Intuiti0n/Projeto1-Smartband/reports/smartband_grupo3.pdf

# Projeto 1 – SmartBand

Micro e nanotecnologias

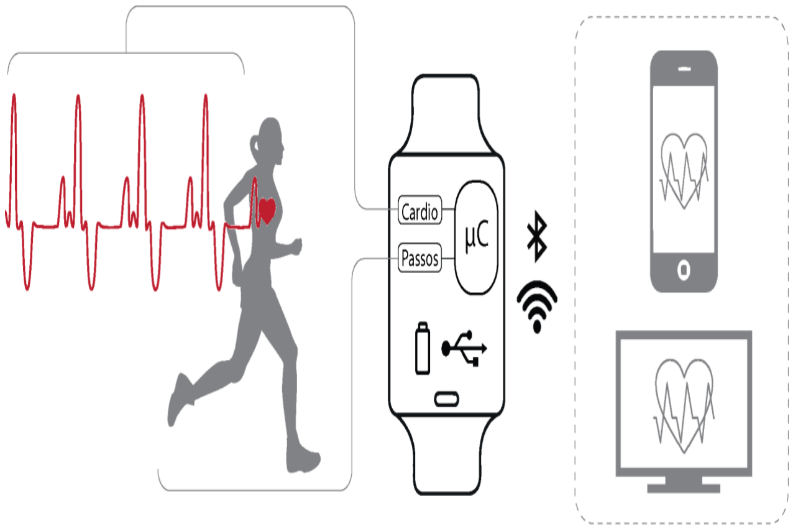
[picture p34: figure]

Trabalho realizado por:

Daniel Gomes A74729

Tiago Ferreira A71970

Pedro Vila-Chã A76468

Orientador do projeto:

Alexandre Silva

## Índice

Figura 6-dados da aceleração, vistos no dispositivo móvel. EIXO X, Y E Z correspondem,

Figura 18 fotopletismografia, esquema | Erro! Marcador não definido.
Figura 19 Diagrama de blocos do sensor de pulsação | Erro! Marcador não definido.
Figura 20-sinal amarelo: Saída do sensor, entrada do filtro. Sinal azul: sinal a saída do filtro
| Erro! Marcador não definido.
Figura 21 bloco amplificador | Erro! Marcador não definido.
Figura 22 imagem do sinal recolhido na porta serie do Arduino | Erro! Marcador não
definido.
Tabela 1-Preço dos vários componentes | Erro! Marcador não definido.

## Sumário

Neste projeto teve-se como principal objetivo a produção de uma

SmartBand que fosse competente a ponto de ser comparada com as já

existentes no mercado. Para que isso acontecesse, torna-se fundamental que

tanto o leitor de pulsos como o sensor de passos funcionem de forma o mais

preciso e fiável possível. Neste momento, finalizado o projeto, ficou

implementado o sensor de pulsação, o sensor de passos, sendo possível

observar os dados recolhidos por estes sensores num computador ou dispositivo

móvel (utilizando Bluetooth). A tentativa de implementação do projeto de uma

forma mais compacta, utilizando uma PCB, não resultou como esperado, sendo

detetados problemas na mesma durante os testes e portanto não foi possível

implementar o sistema desta forma.

A preocupação principal deste projeto foi uma aquisição limpa do sinal

que vinha do medidor de pulsos. Sendo esta a parte mais complicada, foi

necessário investir muito tempo e procurar diferentes métodos de tratamento dos

dados recolhidos. Era essencial que o sinal lido pelo hardware fosse o menos

distorcido possível de forma a facilitar o tratamento dessa mesma informação no

microcontrolador.

## Breves conclusões:

No geral, o projeto cumpriu os requisitos, sendo possível adquirir dados

dos vários sensores, visualiza-los num ecrã, por porta serie num computador ou

através de um dispositivo móvel utilizando Bluetooth.

## Introdução

Todos os elementos tiveram como primeira opção a escolha do projeto da

SmartBand, não só por estar incutido diretamente nas cadeiras que os alunos

estão a frequentar, mas também pela motivação que o projeto por si só oferecia,

sendo algo moderno e que cada vez mais ganha destaque no mercado dos

wearables, tornando o projeto mais aliciante.

O primeiro objetivo deste projeto era o de desenvolver um sensor de

pulsação, capaz de detetar os batimentos cardíacos de forma a calcular os

batimentos por minuto do utilizador da smartband. Para que tal fosse possível,

obrigou a que fosse realizado um estudo para determinar de que forma seria

mais fácil de detetar os batimentos, com que sensores e entre que valores varia

a frequência cardíaca dos humanos, de forma a desenvolver o circuito do sensor,

implementar o sensor numa bracelete e calcular os batimentos utilizando um

microcontrolador.

O segundo objetivo deste projeto centrou-se no desenvolvimento de um

sistema de aquisição de passos da marcha, o que levou a procura de informação

sobre qual sensor deveria ser utilizado, que algoritmo utilizar para contar os

passos efetuados pelo utilizador, como evitar que fosse detetado um passo

quando a pessoa efetua gestos estando parada, etc.

O terceiro objetivo consistia na visualização dos dados recolhidos pelos

sensores em tempo real num computador e também o seu envio por meio sem

fios para um terminal móvel, de forma a que fosse possível analisar a informação

que estava a chegar em qualquer momento. No caso do terminal móvel foi

desenvolvida uma aplicação, referida posteriormente neste relatório, que permite

visualizar os dados de forma mais intuitiva e simples.

O quarto objetivo resume-se a adicionar funções adicionais aquelas

especificadas no início deste projeto, neste caso consiste na visualização dos

dados num ecrã oled de 0,91 polegadas, sendo, portanto, possível observar os

dados dos sensores de três formas distintas.

## Estado da arte:

Seria impossível contornar o facto de o nosso projeto ser parecido com a

smartband mais utilizada do mercado “Xiaomi MiBand” de maneira que tentamos

sempre encontrar soluções baseando-nos em protocolos já existentes,

implementados e funcionais em dispositivos do mesmo tipo.

A principal fonte de informação foi pesquisada e encontrada em páginas

web, sendo a internet o meio que contém mais informação disponível ao alcance

de um “click”. No entanto, muitas vezes tivemos de aprofundar a pesquisa devido

à quantidade de informação disponível, que por vezes não tinha a maior

fidelidade.

Aproximando-se a reta final para entrega do projeto, era incontornável o

facto da implementação em pcb ter sido um fracasso, porém todos os

componentes conseguiam trabalhar em simultâneo e até houve opção de

adicionar um pequeno LCD que fornecia informação sobre o modo em que

estava (modo “0” -leitor de frequência cardíaca, modo”1” -contador de passos).

Outra funcionalidade que o MPU-6050 contém é a leitura da temperatura

ambiente, que foi devidamente testada e implementada com sucesso, porém não

chegou a avançar para o protótipo final.

Em suma, todos os componentes foram estudados previamente e

tentámos implementar cada um da maneira que achámos mais plausível e que

poderia trazer mais vantagens ao nosso projeto como produto.

Divisão do relatório:

Este relatório encontra-se dividido em 3 partes principais: fundamentos

teóricos, onde se descrevem os estudos realizados para os sensores de

pulsação e o de passos; trabalho realizado onde se descreve as dificuldades

encontradas, métodos utilizados e escolha de certos componentes; resultados

onde se indicam os resultados obtidos dos testes, ilustrados com imagens.

## Fundamentos teóricos:

Foto pletismografia (pulsação)

Uma das partes mais importantes deste projeto consiste na

implementação de um sistema de leitura de batimentos cardíacos, que fosse

robusto e o mais fiável possível. Para tal foi necessário realizar uma pesquiza

mais aprofundada sobre o tema em questão visto nenhum dos elementos do

grupo ter uma noção profunda sobre o assunto, sendo consultados vários

websites de fontes fidedignas sobre leitores de batimentos cardíacos, sendo que

foi descoberta a partida que os batimentos de uma pessoa se encontram

normalmente entre os 50 e os 240 por minuto, sendo 50 o valor de repouso e

240 um valor de grande esforço físico. De antemão já era conhecido o sistema

que iriamos utilizar, este fornecido pelo docente Prof. Alexandre Silva que

consistia | num | led | que | emitia | luz | verde | intensa | e | um | LDR

(Light Dependent Resistor) que seria o elemento que deteta as variações de

luminosidade.

Dado estes componentes, foi necessário elaborar um sistema que

conseguisse detetar a pulsação, (sensor do batimento cardíaco) baseando-se no

princípio da foto pletismografia. Este princípio consiste na medição da mudança

de volume de sangue através de qualquer órgão, que provoca do mesmo modo

uma variação na intensidade luminosa da região vascularizada. Neste caso,

como o que interessava era a medição da frequência da pulsação cardíaca, o

tempo entre pulsos é fundamental e deve ser detetado de forma precisa para

garantir um bom cálculo dos batimentos por minuto.

O fluxo de volume sanguíneo é dado pela taxa de pulsos cardíacos e,

como a luz é absorvida pelo sangue, os pulsos de sinal são equivalentes aos

pulsos de batimento cardíaco.

Aprofundando a pesquisa, foram encontrados dois tipos de foto pletismografia:

- Transmissão: A luz emitida a partir do dispositivo emissor de luz é

transmitida através de qualquer região vascular do corpo como o lóbulo

da orelha e recebida pelo detetor.

- Reflexão: A luz emitida pelo dispositivo emissor de luz é refletida pelas

regiões.

Acelerómetros para os passos:

Para contar os passos, foi necessário investigar sobre diferentes formas

de o fazer, sendo que o método adotado foi o de identificar um padrão de marcha

utilizando os eixos do acelerómetro. Era necessário entender de que forma os

valores obtidos pelo sensor eram importantes na contagem dos passos, se

apenas era dada importância a um dos eixos do acelerómetro, a dois dos eixos

ou a combinação dos três (calculando o vetor de aceleração total).

## Trabalho realizado:

Para o sensor de pulsação:

Para ser possível analisar a pulsação foi necessário criar um circuito que

fizesse com que os leds emitissem luz e no meio dos leds colocar o LDR

(elemento sensor), colocar estes elementos em contacto com o pulso e

consoante o fluxo sanguíneo (quanto maior o fluxo mais seria a luz absorvida,

ou seja, menos luz emitida para o LDR) receberíamos um valor de tensão que

variaria conforme o fluxo.

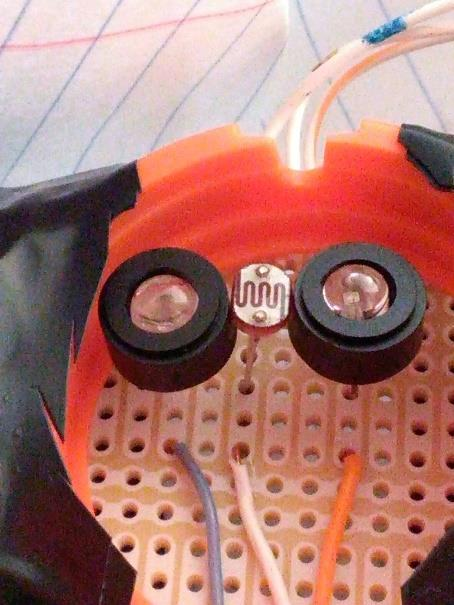
[picture p35: figure]

Figura 2-LDR e LEDs

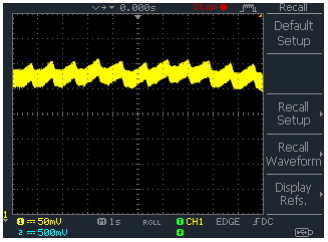
[picture p36: figure]

A variação da tensão à saída do LDR é inversamente proporcional ao fluxo

de sangue, caso o fluxo de sangue seja maior, maior será a absorção da luz,

logo menor será a luz refletida que o LDR captará de modo que terá menor valor

de tensão. Por outro lado, caso o fluxo seja menor, menor será a absorção de

luz, sendo maior a luz refletida para o LDR o que fará com que haja maior tensão

à sua saída. Este sinal é, na verdade, um sinal que varia de acordo com os

batimentos cardíacos, portanto a componente principal que era necessário isolar

era a do batimento. De forma a filtrar o ruído existente nesse sinal, foi necessário

implementar um filtro passivo passa banda, sendo que os limites para as

frequências foram determinados através do estudo prévio do sinal cardíaco.

Como os batimentos variam entre os 50 e os 240, isso corresponde a uma banda

de frequências que se encontra entre os 0,83Hz e os 4Hz. Portanto foi

Figura 1-Sinal á saída implementado um filtro passa banda de 0,5Hz a 10Hz de forma a atenuar apenas

as frequências que não se encontrassem na gama do sinal cardíaco.

Em termos de circuito isto correspondeu a implementar um filtro passivo

(utilizando apenas resistências e condensadores) cujos valores de frequência de

corte são os seguintes:

FC =

1
2 ∗ π ∗ R ∗ C

FC1 =

1
2 ∗ π ∗ 470k ∗ 680n = 0,50 Hz

FC2 =

1
2 ∗ π ∗ 160k ∗ 100n = 9,95 Hz

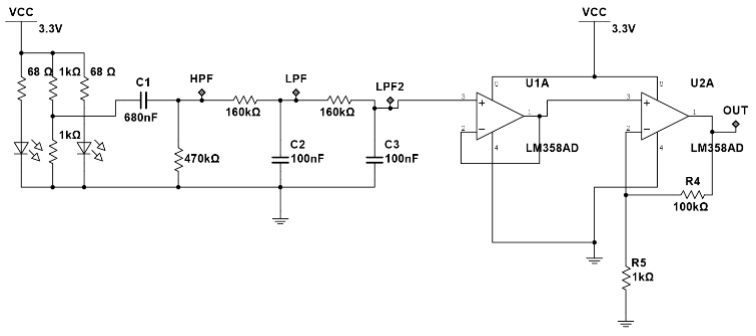
[picture p37: figure]

Foram utilizados 2 filtros passa baixo seguidos de forma a atenuar sinais

de alta frequência que estavam a perturbar a aquisição do sinal cardíaco, quando

se iniciaram os testes ao primeiro filtro implementado.

Figura 3-Circuito completo

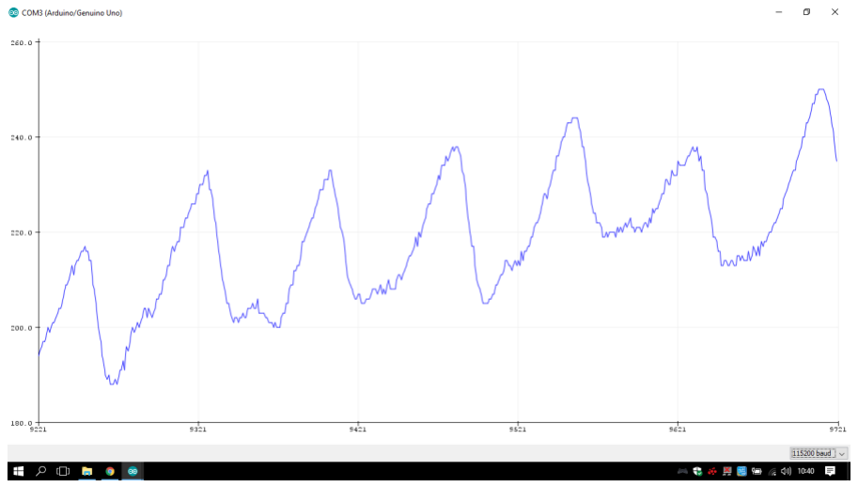
[picture p38: figure]

Dado que o sinal que estava a ser adquirido pelo microcontrolador possuía

uma componente DC que dificultava a tarefa da contagem dos batimentos,

recorreu-se a um filtro digital, de forma a normalizar o sinal e centrar em torno

de uma referência (valor 0).


Figura 5-Sinal após implementação do filtro digital

Após a implementação deste circuito e do filtro digital e posteriores testes,

foi possível criar um algoritmo de contagem dos batimentos. Todos os algoritmos

definidos se basearam num principio: o sinal passava por zero a cada pulso.

Portanto, inicialmente foi criado um algoritmo que a cada vez que o valor do sinal

passava de negativo para positivo (transição positiva) contava uma pulsação. De

Figura 4-Sinal á saída da porta série no Arduino forma a estimar os batimentos por minuto, num período de 6 segundos eram

contados os batimentos que ocorreram e o seu valor era multiplicado por 10 de

forma a estimar o valor de BPM (batimentos por minuto).

Este algoritmo, embora muito simples de implementar, revelou-se muito

pouco preciso devido a apenas ter em conta o numero de batimento que ocorrem

naquele espaço de tempo e não o tempo que cada pulso demora.

Portanto, implementou-se um novo algoritmo, que consistia em anotar o

tempo que cada pulso, em 5 pulsos, realizar uma regra de três simples e estimar

o valor de BPM. Este algoritmo, embora melhor que o primeiro, revelou-se muito

sensível a falsas leituras ou erros na leitura. Portanto procedeu-se a elaboração

de um sistema mais robusto.

O algoritmo que se revelou o melhor de todos consiste na anotação de 5

tempos em que o sinal passa pela referencia, determinar o período de 4 pulsos,

dividir por 4 o valor obtido e calcular deste modo a frequência (frequência é o

inverso do período). Como se realiza a media dos pulsos, os erros na leitura do

sinal são desta forma atenuados e deste modo é obtido um cálculo mais

aproximado do valor real.

## Para o sensor de passos:

Inicialmente foi efetuada uma recolha de dados, colocando o modulo com

acelerómetro no pulso e analisando os dados a procura de um padrão. Foi

possível verificar que dada a posição do sensor no pulso, os eixos Y e Z de

aceleração era aqueles em que era mais facilmente percetível o padrão da

marcha [ver figura X], obtendo picos em ambos os eixos. Dado que por vezes

com o movimento natural dos braços do utilizador um desses eixos não dava um

pico acentuado, foi necessário combinar a informação dos sinais dos 2 eixos.

Primeiro foi adotada a estratégia de uma soma aritmética dos valores dos 2

eixos, sendo posteriormente decidido que uma multiplicação aritmética dos

valores a cada instante permitiria realçar o aumento dos valores quando a

pessoa efetua a passada. A partir desta operação, foi possível estabelecer um

algoritmo básico de deteção dos passos, sendo que este consiste na comparação com um valor base e sempre que os dados provenientes do sensor

ultrapassam este limiar, aumenta o numero de passos.

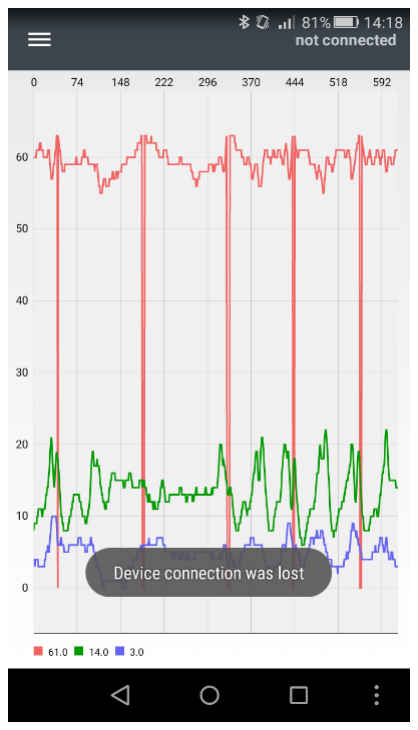
[picture p39: figure]

Figura 6-dados da aceleração, vistos no dispositivo móvel. EIXO X, Y E Z correspondem, respetivamente as cores vermelho, verde e azul

A aquisição de passos recorreu a utilização do sensor MPU-6050, que medirá a aceleração do braço.
Este sensor contém um acelerómetro e um
giroscópio num único chip. Tendo 16-bits para cada
canal de conversão ADC e o facto de captar os eixos X, Y, Z tornam este módulo ideal para a contagem dos passos. O sensor usa o protocolo I2C para realizar a comunicação com o Arduíno.
Uma das principais preocupações neste projeto
foi o baixo consumo de energia, pois este será
alimentado recorrendo a uma bateria, sendo este

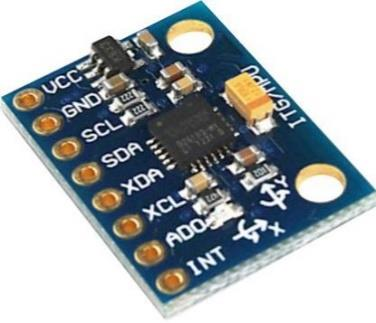
[picture p40: figure]

módulo uma boa escolha devido a possuir uma função de “sleep” não requer um alto consumo sendo esta uma das características que levou a que fosse escolhido.

Figura 7-MPU-6050

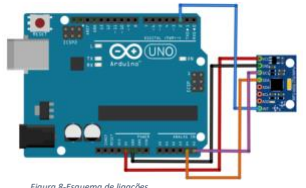
[picture p41: figure]

## Desenvolvimento de aplicação

Ao utilizar o módulo Bluetooth para a comunicação sem fios com o dispositivo Android pensou-se que seria melhor desenvolver uma aplicação, para tal recorreu-se ao “MIT app Inventor”, que é um ambiente de desenvolvimento de fácil compreensão, com exemplos que auxiliam a sua utilização. Dada a inexperiência dos membros do grupo a programar uma aplicação móvel, esta foi a opção mais sensata, pois este utiliza programação por blocos para executar os diversos comandos.

O objetivo da aplicação seria o de apresentar os gráficos dos três eixos que são enviados pelo acelerómetro, tendo também um pequeno botão para conectar ou desconectar. O layout da aplicação estará apresentado na figura seguinte assim como o diagrama de blocos utilizado.

Figura 8-Esquema de ligações

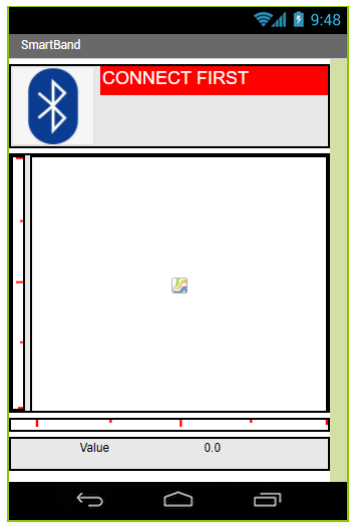
[picture p42: figure]

Figura 9-Layout da aplicação

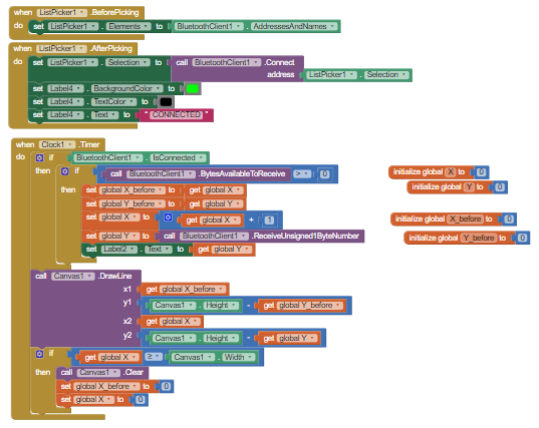
[picture p43: figure]

## Escolha do microcontrolador:

Dada a variedade de microcontroladores existentes no mercado, foi possível escolher um que se enquadrasse nas necessidades deste projeto de forma a ajudar no funcionamento de todo o sistema. Devido ao seu tamanho reduzido, foram considerados os seguintes microcontroladores: Arduino Nano, Arduino Pro Mini,

Adafruit Trinket.

Dados estes 3 dispositivos, foi selecionado o Arduino Pro Mini, devido a possuir um custo muito reduzido, tamanho bastante reduzido devido a não possuir uma ligação direta por usb e características internas (como por exemplo a alimentação de 3.3V, velocidade de 8MHz, bastantes pinos disponíveis caso existam funcionalidades extra a serem implementadas mais tarde) favoráveis em relação às outras opções.

Figura 10-Diagrama de blocos

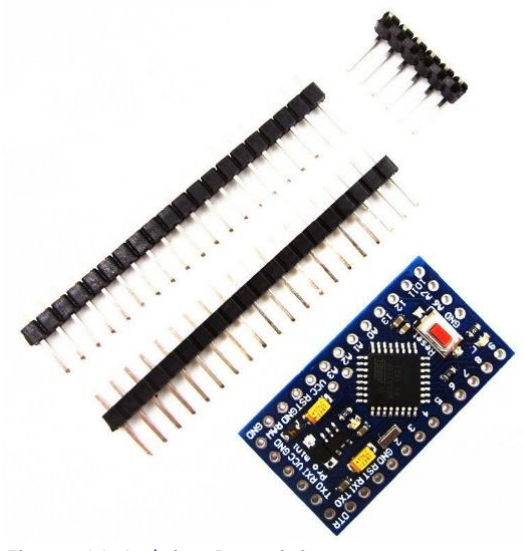
[picture p44: figure]

Figura 11-Arduino Pro mini

## Envio dos dados por Bluetooth:

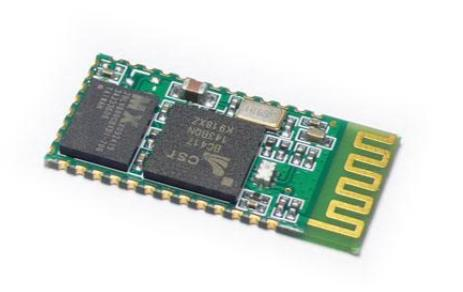
[picture p45: figure]

De forma a que fosse possível observar os dados obtidos pelos sensores num terminal móvel, foi necessário escolher um módulo Bluetooth, sendo que o escolhido foi o HC-05, devido ao seu preço, fácil programação e configuração e sendo este um módulo já utilizado por alguns membros do grupo antes deste projeto, foi a escolha mais fácil de implementar.

## Resultados obtidos:

Do sensor de pulsação:

Figura 12-módulo Bluetooth HC-05

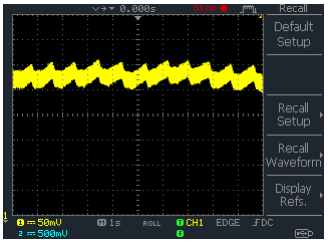
[picture p46: figure]

Figura 13-Sinal obtido do LDR

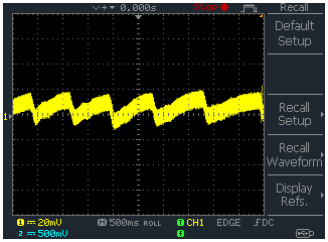
[picture p47: figure]

Figura 14-sinal do filtro passa baixo

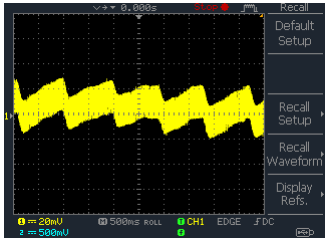
[picture p48: figure]

Figura 15-Sinal após filtro passa-alto

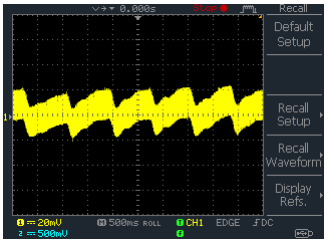
[picture p49: figure]

Figura 16-Sinal após filtro passa-alto e primeiro filtro passa-baixo

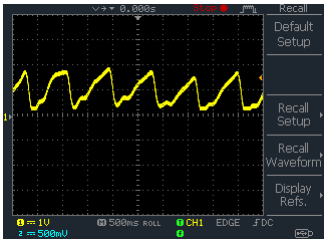
[picture p50: figure]

Figura 17-Sinal após filtragem e amplificação

## Conclusões e perspetivas futuras:

Com o projeto realizado ganhámos muita experiência a trabalhar como

um grupo devidamente estruturado. Devido ao facto de o trabalho ter uma

duração diferente de outros projetos realizados no passado, permitiu delinear

uma estratégia mais específica e real comparando ao mercado de trabalho.

Apesar de vários contratempos ao longo do semestre sendo um dos mais

perseverantes a implementação em PCB, podemos concluir que conseguimos

levar a bom porto o projeto. Quer na parte da medição da frequência, quer na

contagem dos passos ambos foram implementados com sucesso.

Em suma todo o trabalho que necessitou o projeto, toda a ajuda fornecida

pelo Professor encarregue, todos os contratempos e todos os sucessos colocam

nos em posição de afirmar que no geral o projeto foi muito enriquecedor para

todos os elementos do grupo, e com a conclusão do mesmo ganhámos ainda

mais experiência para num futuro próximo emergir no mercado de trabalho.

## Bibliografia:

Sensor de pulsação:

https://www.elprocus.com/heartbeat-sensor-circuit-daigram-working-with-8051/

https://www.elprocus.com/phototransistor-basics-and-advantages/

https://www.elprocus.com/heartbeat-sensor-working-application/

Sensor de passos:

http://www.instructables.com/id/Make-your-own-activity-tracker/

http://www.instructables.com/id/Arduino-Watch-With-Altitude-Temperature-Compass-An/ (http://www.instructables.com/id/Arduino-Watch-With-Altitude-Temperature-Compass-An/)

Arduino:

https://learn.sparkfun.com/tutorials/using-the-arduino-pro-mini-33v

## Anexos:

## Anexo A- Lista de compras:

Item
Valor | Total:
Arduino Mini Pro 3.3V 8MHz | 3,99 € | 60,66 €
FTDI 3.3V | 3,50 €
HC-05 | 2,98 €
MPU-6050 | 2,60 €
potenciometro multivolta | 2,00 €
oled 0,91 | 6,39 €
PCB | 5,00 €
header 8 pinos | 0,90 €
header 6 pinos | 0,20 €
conector jst | 0,85 €
bateria | 6,00 €
carregador da bateria | 8,50 €
pente 40 pinos | 0,65 €
bateria 3.7V | 7,95 €
carregador lipo basico | 8,50 €
interruptor | 0,65 €

## Anexo B- Esquemático da PCB:

Tabela 1-Esquemático PCB

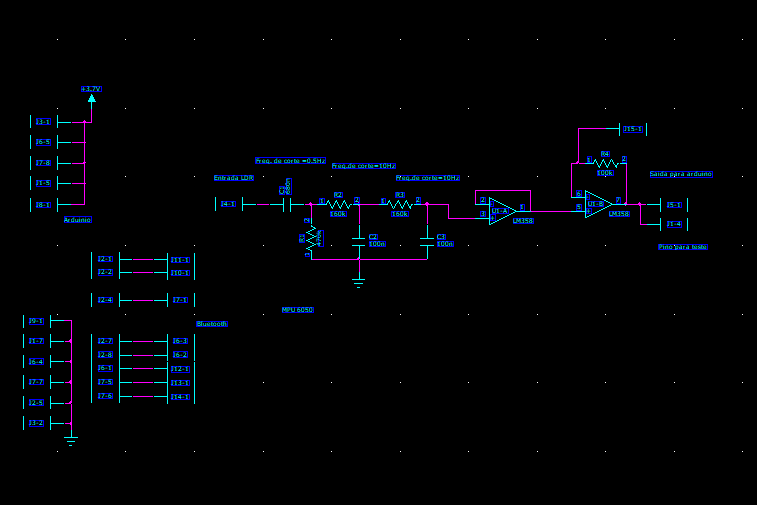
[picture p51: figure]

## Anexo C- Layout da PCB:

Tabela 2-Layout PCB

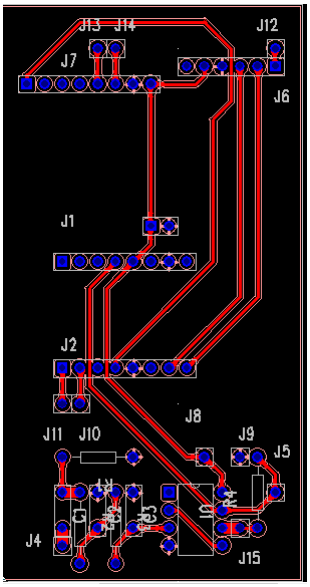
[picture p52: figure]
