Intuiti0n/Projeto1-Smartband/images/51N5FGVZ61L._SY355_.jpg

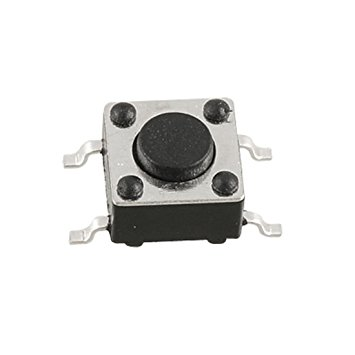
images/51N5FGVZ61L._SY355_.jpg
