Intuiti0n/Projeto1-Smartband/images/bluetooth/hc-05-bluetooth.jpg

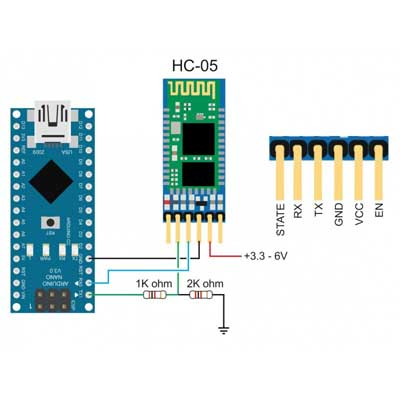
images/bluetooth/hc-05-bluetooth.jpg
