Intuiti0n/Projeto1-Smartband/images/CIRCUITO/25673404_1763918493649535_340483444_o.jpg

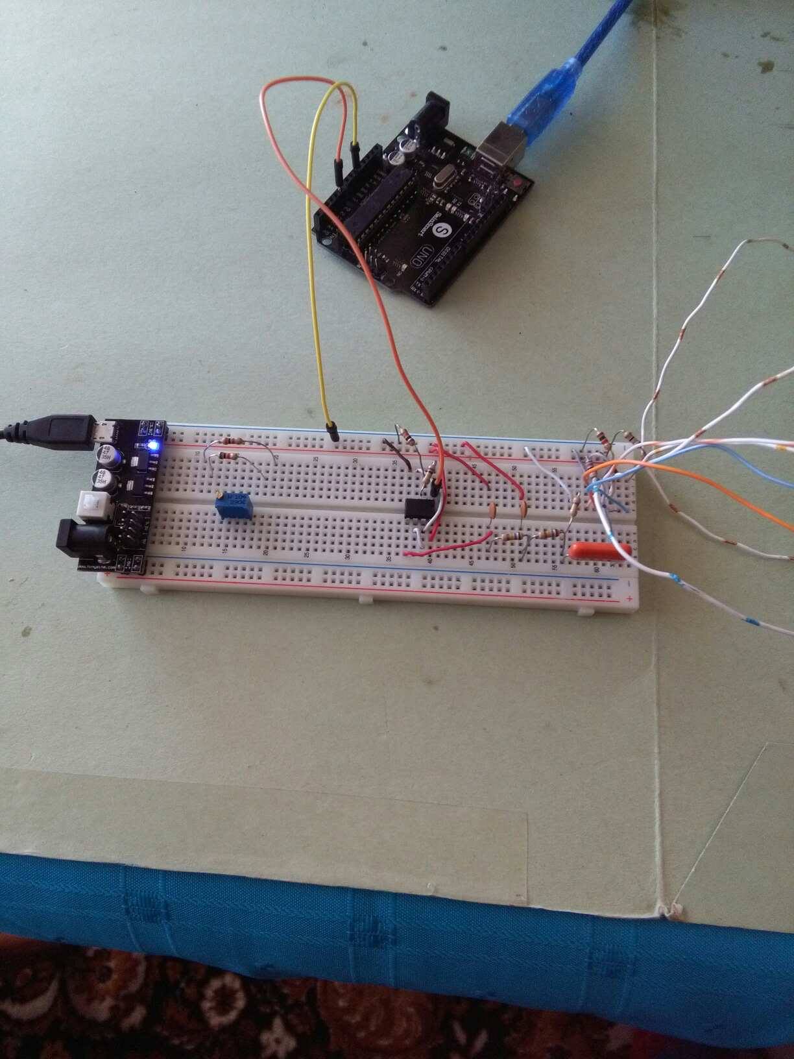
images/CIRCUITO/25673404_1763918493649535_340483444_o.jpg
