Intuiti0n/Projeto1-Smartband/images/CIRCUITO/25829591_1763918126982905_219358563_o.jpg

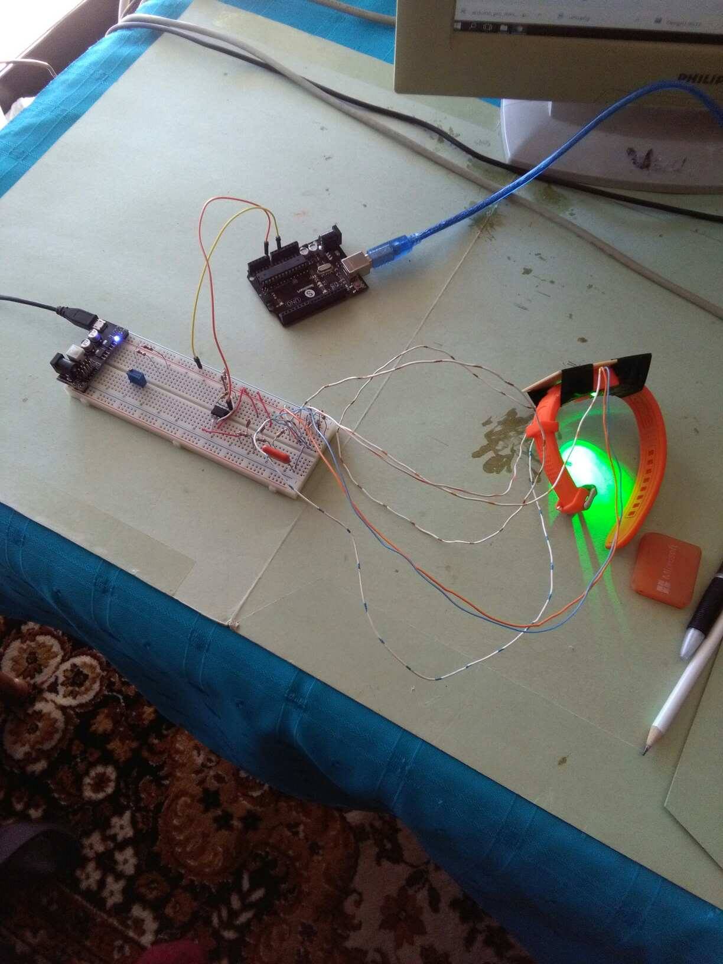
images/CIRCUITO/25829591_1763918126982905_219358563_o.jpg
