Intuiti0n/Projeto1-Smartband/images/CIRCUITO/Captura de Ecrã (60).png

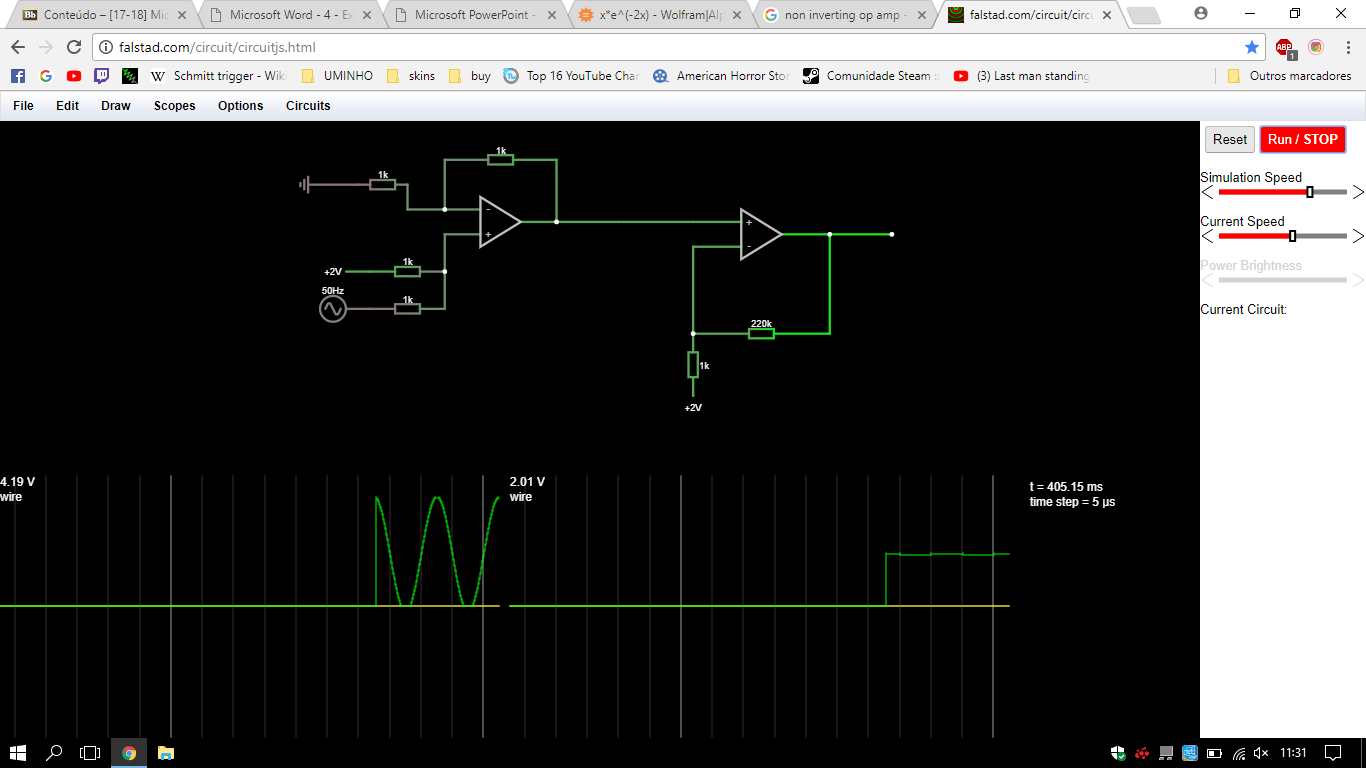
images/CIRCUITO/Captura de Ecrã (60).png
