Intuiti0n/Projeto1-Smartband/images/CIRCUITO/circuit.png

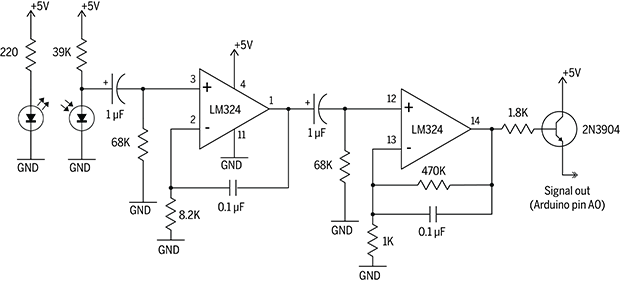
images/CIRCUITO/circuit.png
