Intuiti0n/Projeto1-Smartband/images/CIRCUITO/Heartbeat.png

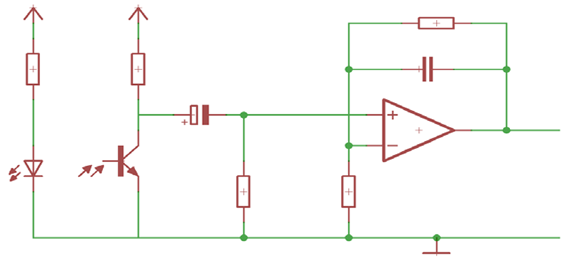
images/CIRCUITO/Heartbeat.png
