Intuiti0n/Projeto1-Smartband/images/final.png

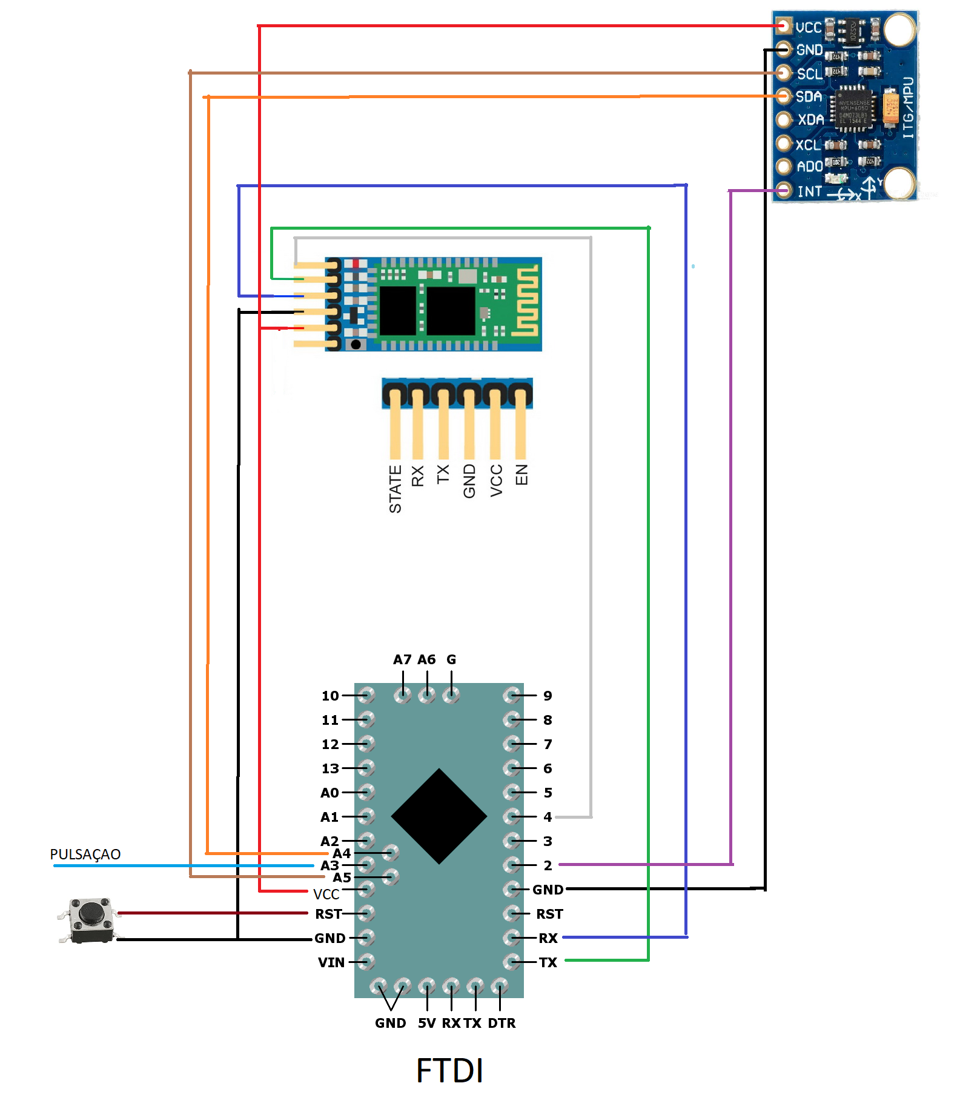
images/final.png
