Intuiti0n/Projeto1-Smartband/images/FU9A6QDHRPNAADC.MEDIUM.jpg

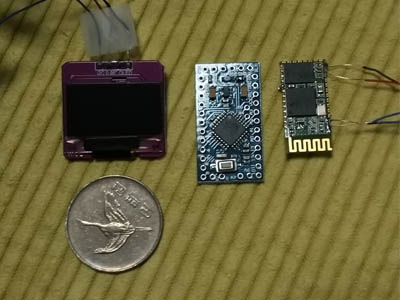
images/FU9A6QDHRPNAADC.MEDIUM.jpg
