Intuiti0n/Projeto1-Smartband/images/HC-05-ZG1643-B23090W_010_Circuit_1200.jpg

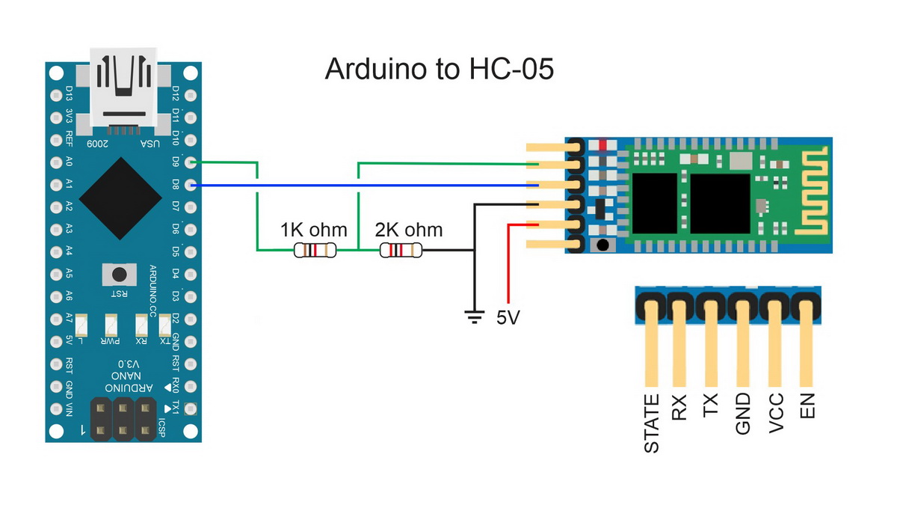
images/HC-05-ZG1643-B23090W_010_Circuit_1200.jpg
