Intuiti0n/Projeto1-Smartband/images/heart/25590484_1761792837195434_1435128039_o.jpg

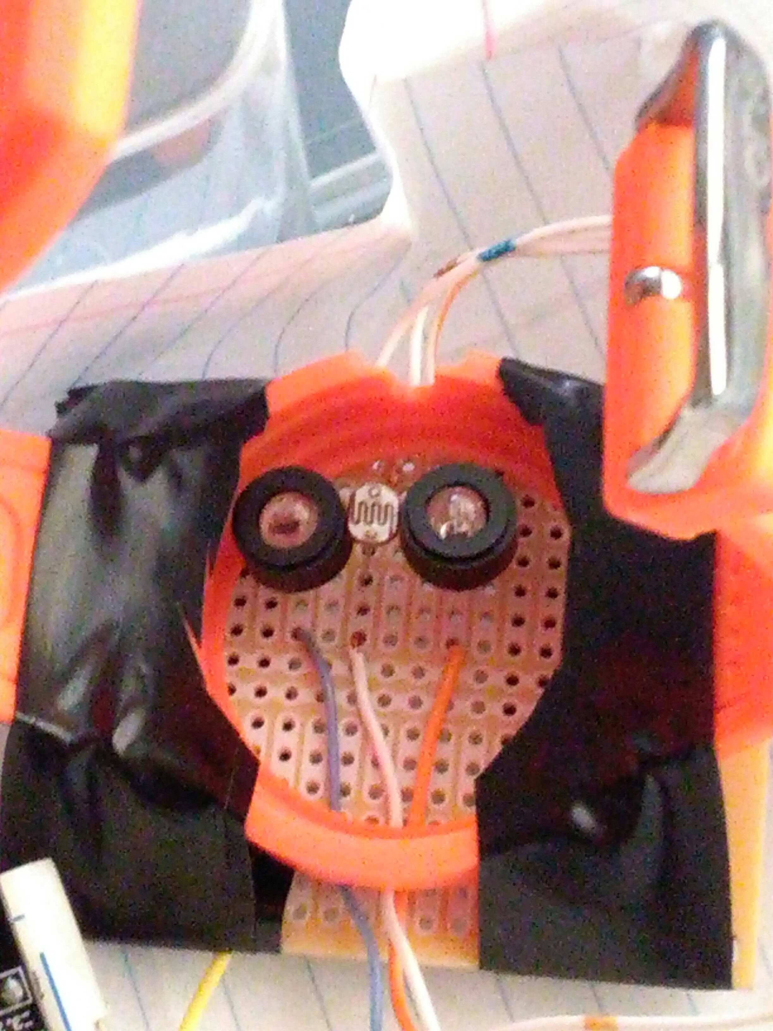
images/heart/25590484_1761792837195434_1435128039_o.jpg
