Intuiti0n/Projeto1-Smartband/images/heart/25625703_1761793057195412_1263326847_o.jpg

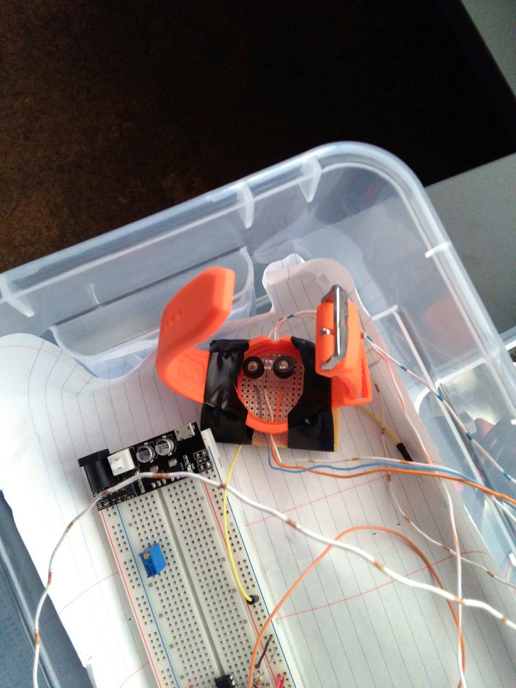
images/heart/25625703_1761793057195412_1263326847_o.jpg
