Intuiti0n/Projeto1-Smartband/images/heart/Captura de Ecrã (102).png

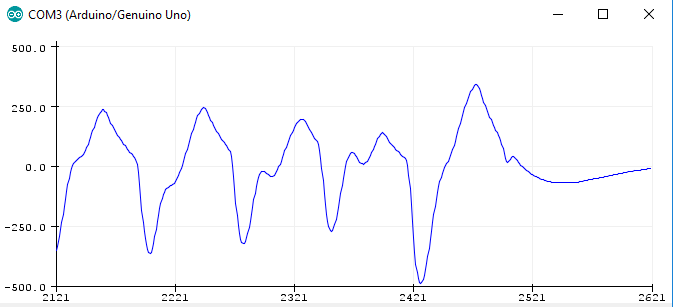
images/heart/Captura de Ecrã (102).png
