Intuiti0n/Projeto1-Smartband/images/heart/Captura de Ecrã (121).png

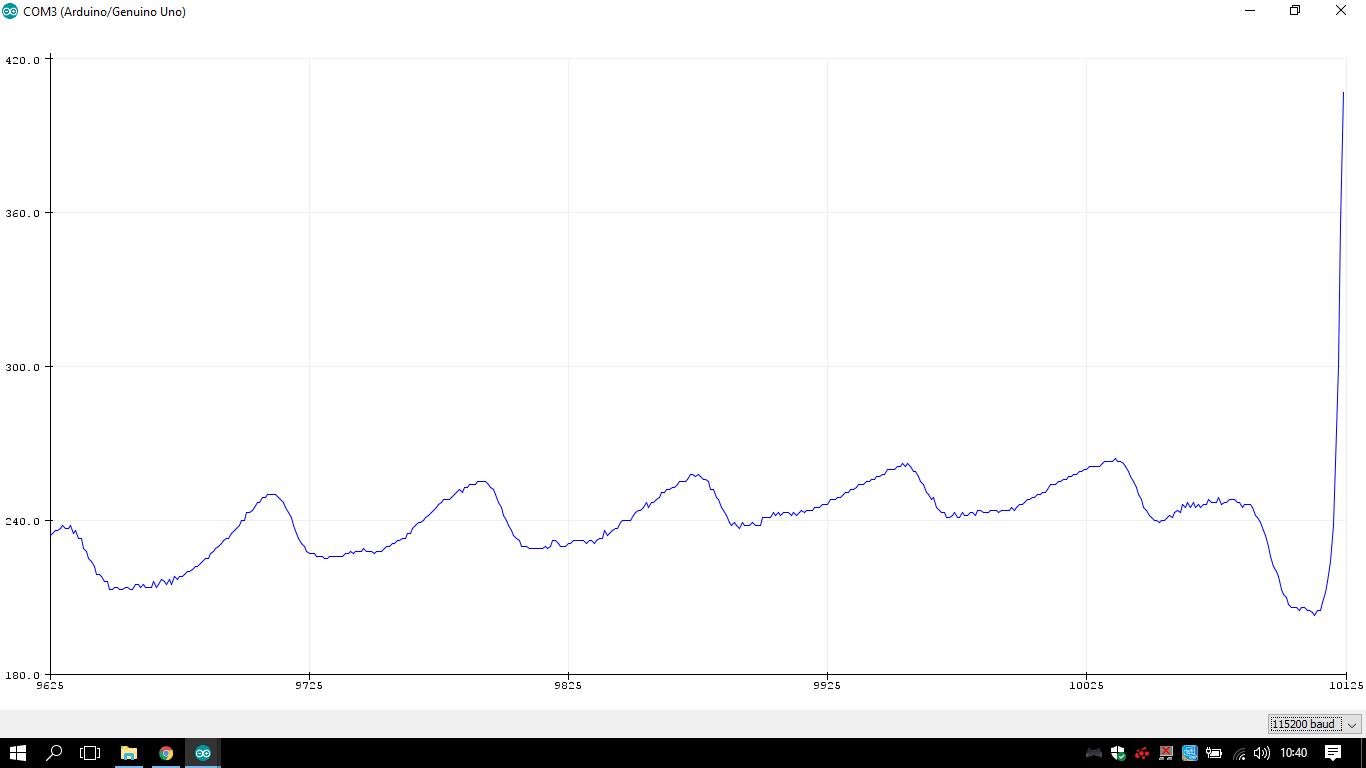
images/heart/Captura de Ecrã (121).png
