Intuiti0n/Projeto1-Smartband/images/heart/Captura de Ecrã (122).png

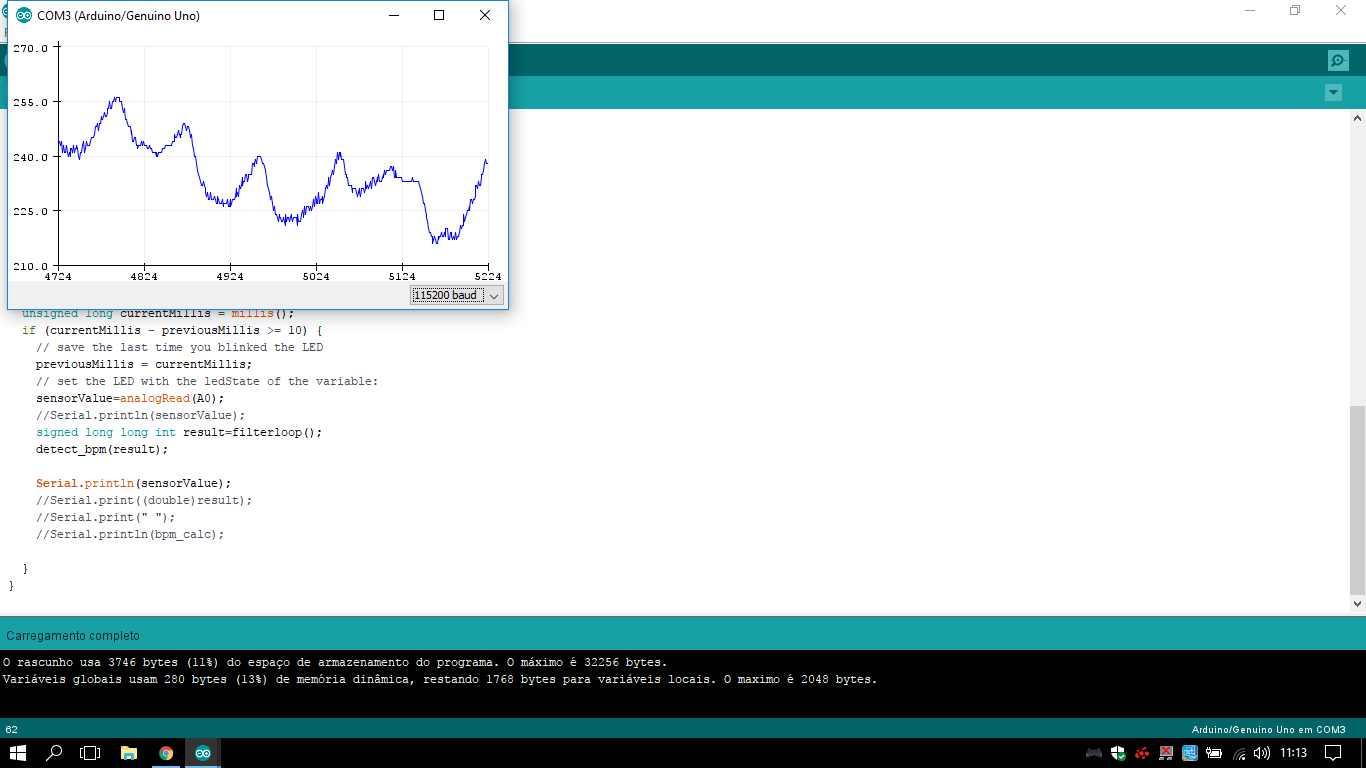
images/heart/Captura de Ecrã (122).png
