Intuiti0n/Projeto1-Smartband/images/milestones.png

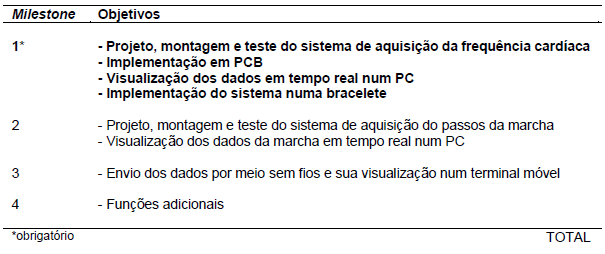
images/milestones.png
