Intuiti0n/Projeto1-Smartband/images/PCB/Captura de Ecrã (146).png

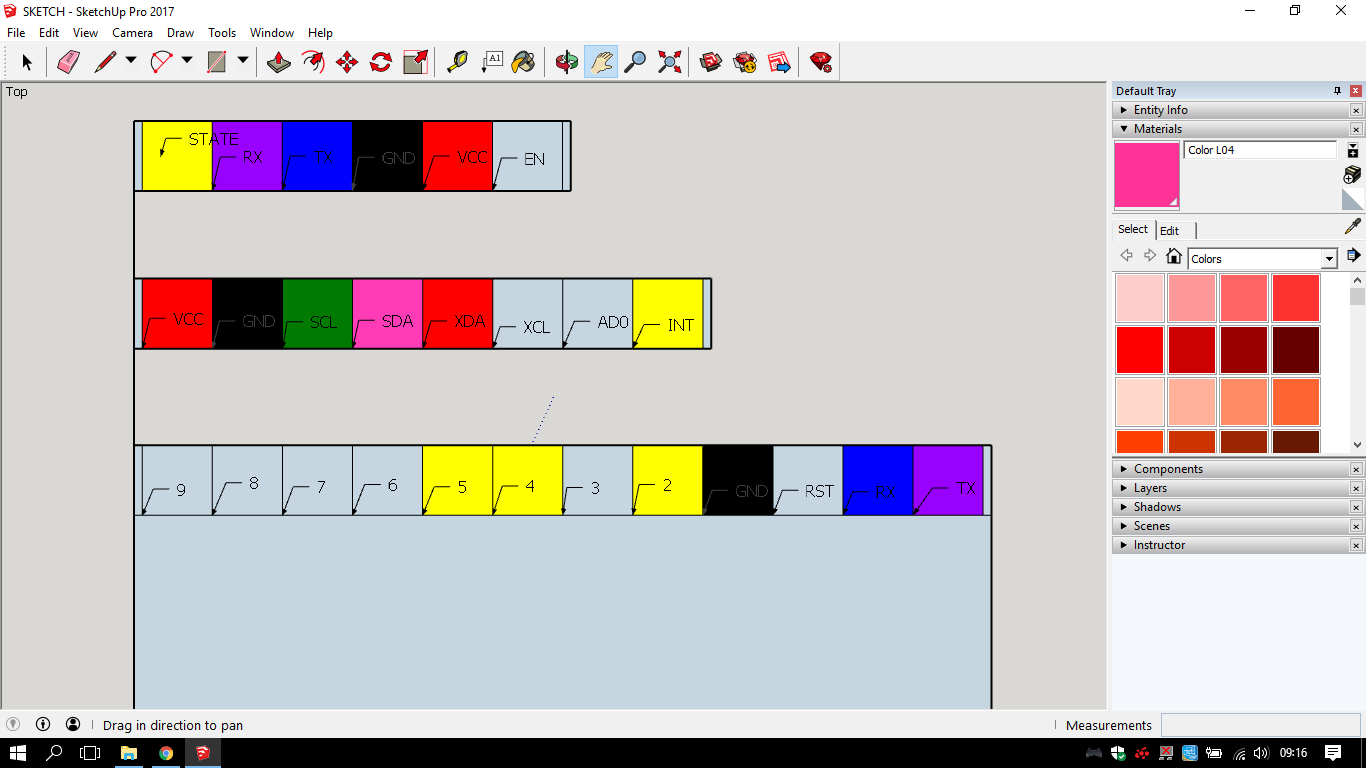
images/PCB/Captura de Ecrã (146).png
