Intuiti0n/Projeto1-Smartband/images/PCB/Captura de Ecrã (147).png

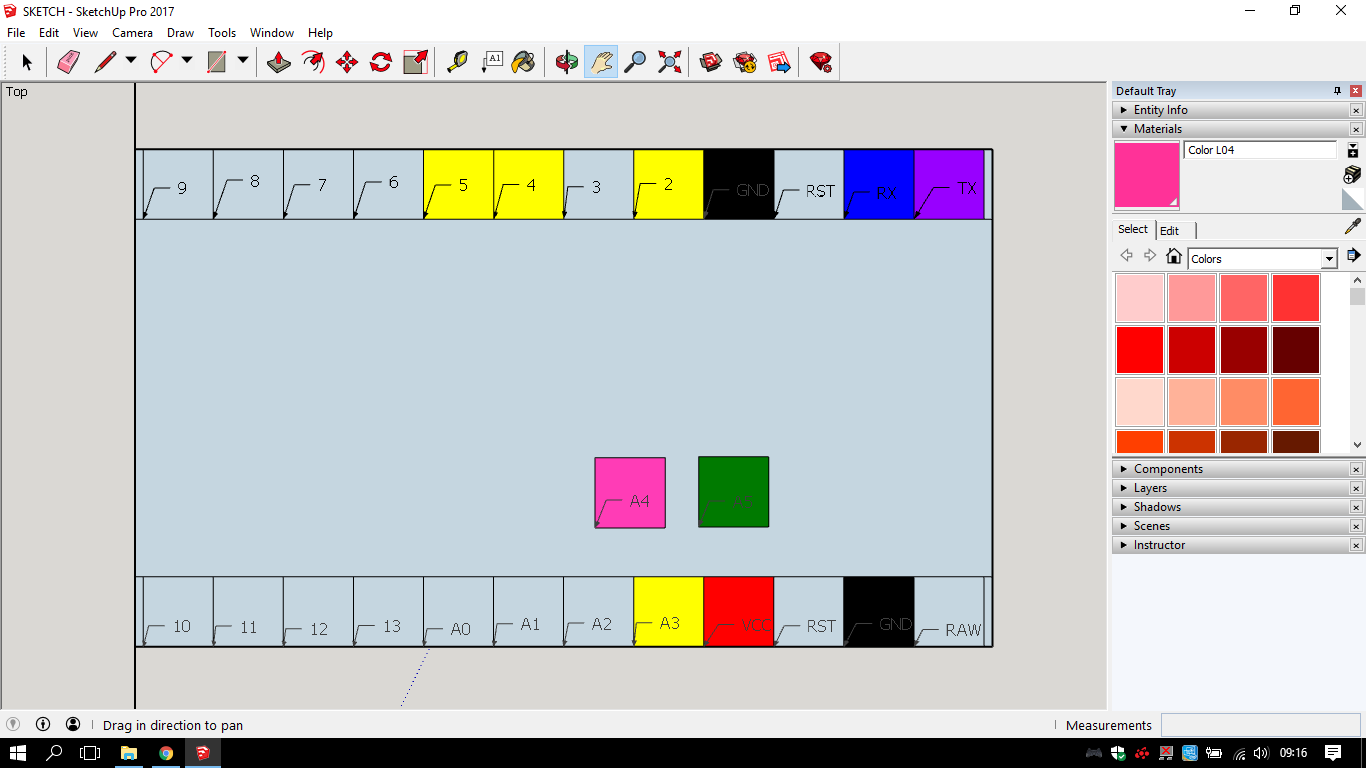
images/PCB/Captura de Ecrã (147).png
