Intuiti0n/Projeto1-Smartband/images/PCB/Captura de Ecrã (148).png

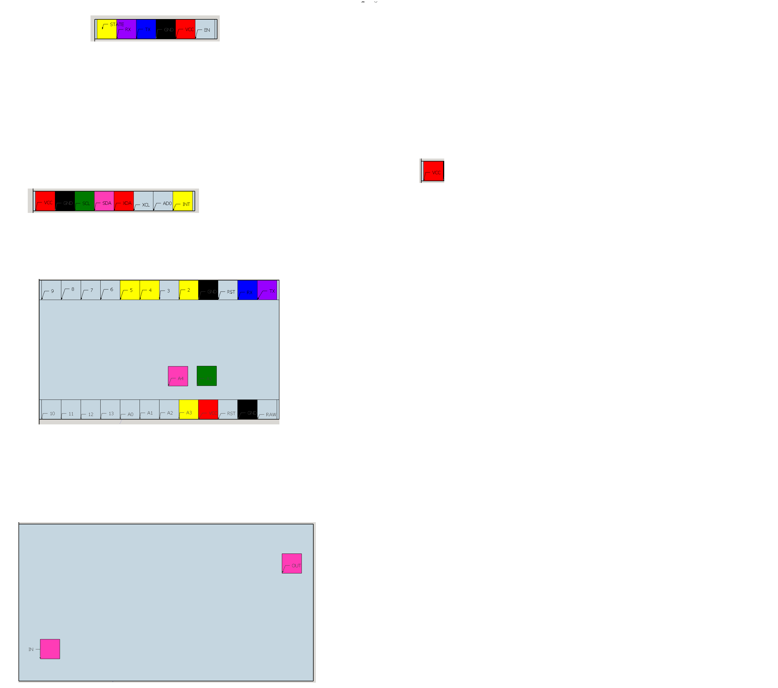
images/PCB/Captura de Ecrã (148).png
