Intuiti0n/Projeto1-Smartband/images/PCB/PCB_FINAL.png

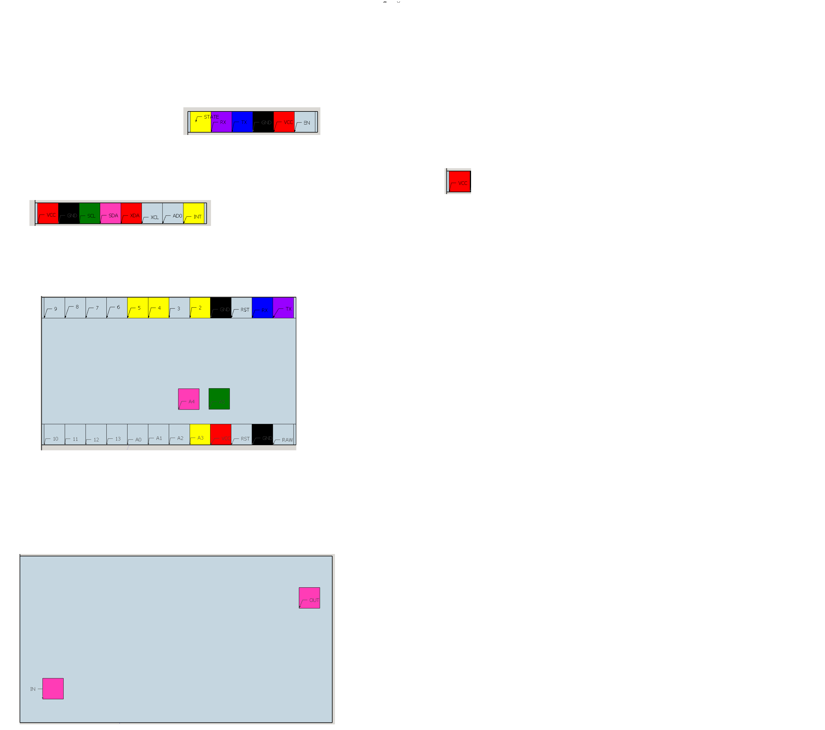
images/PCB/PCB_FINAL.png
