Intuiti0n/Projeto1-Smartband/images/pinout-deek-robot-pro-mini.png

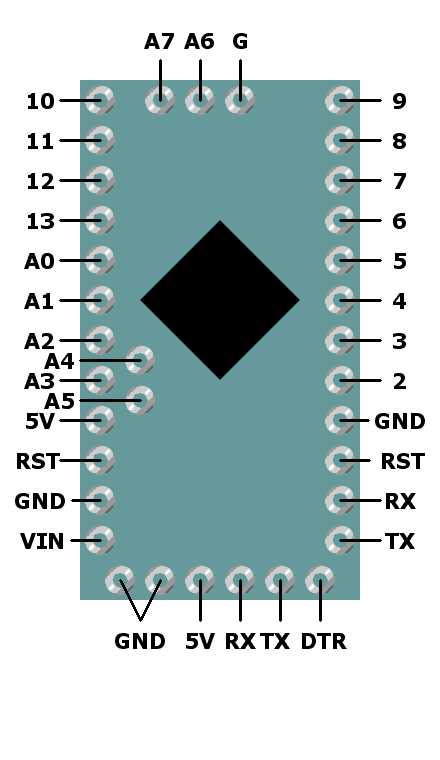
images/pinout-deek-robot-pro-mini.png
