Intuiti0n/Projeto1-Smartband/images/report_images/1.png

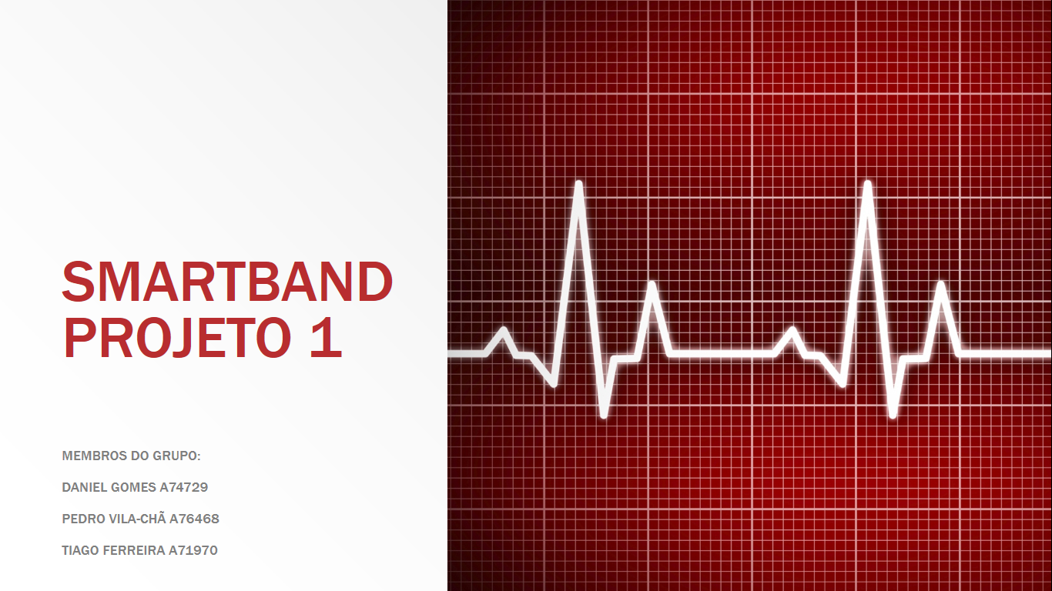
images/report_images/1.png
