Intuiti0n/Projeto1-Smartband/images/report_images/2.png

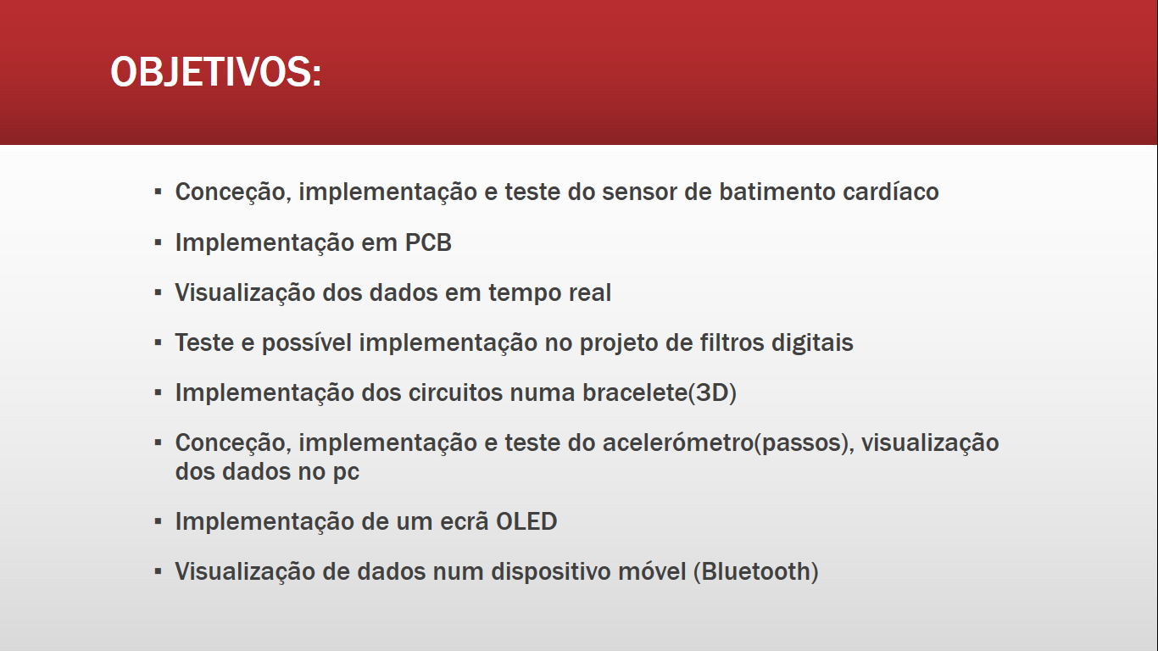
images/report_images/2.png
