Intuiti0n/Projeto1-Smartband/images/report_images/3.png

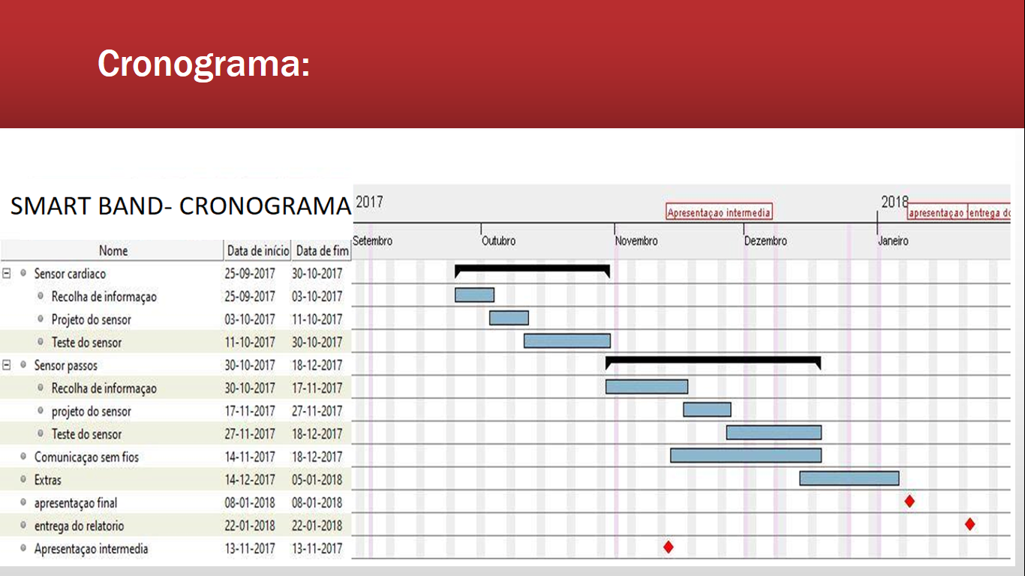
images/report_images/3.png
