Intuiti0n/Projeto1-Smartband/images/report_images/4.png

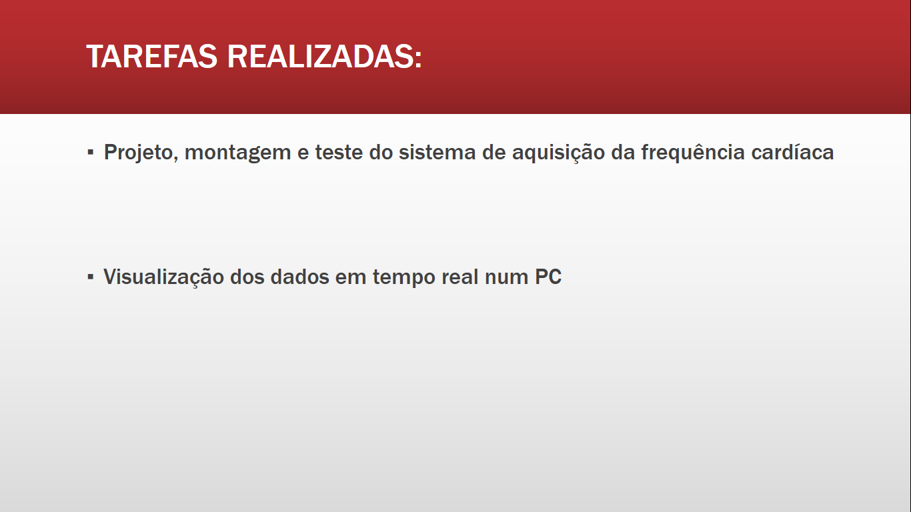
images/report_images/4.png
