Intuiti0n/Projeto1-Smartband/images/report_images/5.png

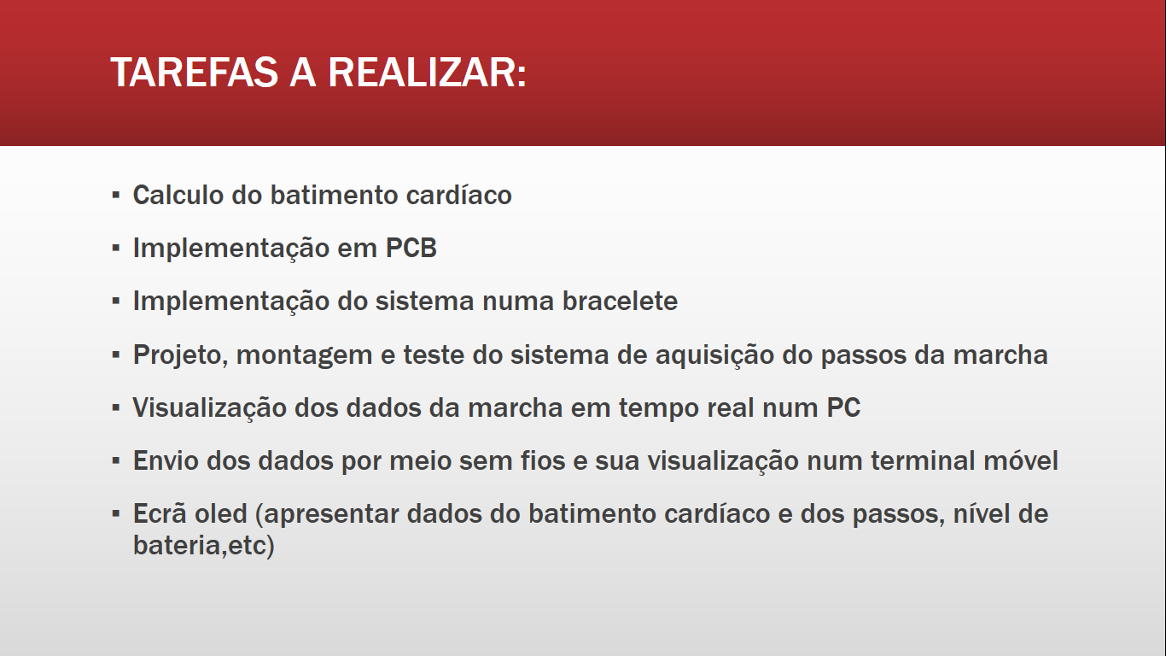
images/report_images/5.png
