Intuiti0n/Projeto1-Smartband/images/report_images/6.png

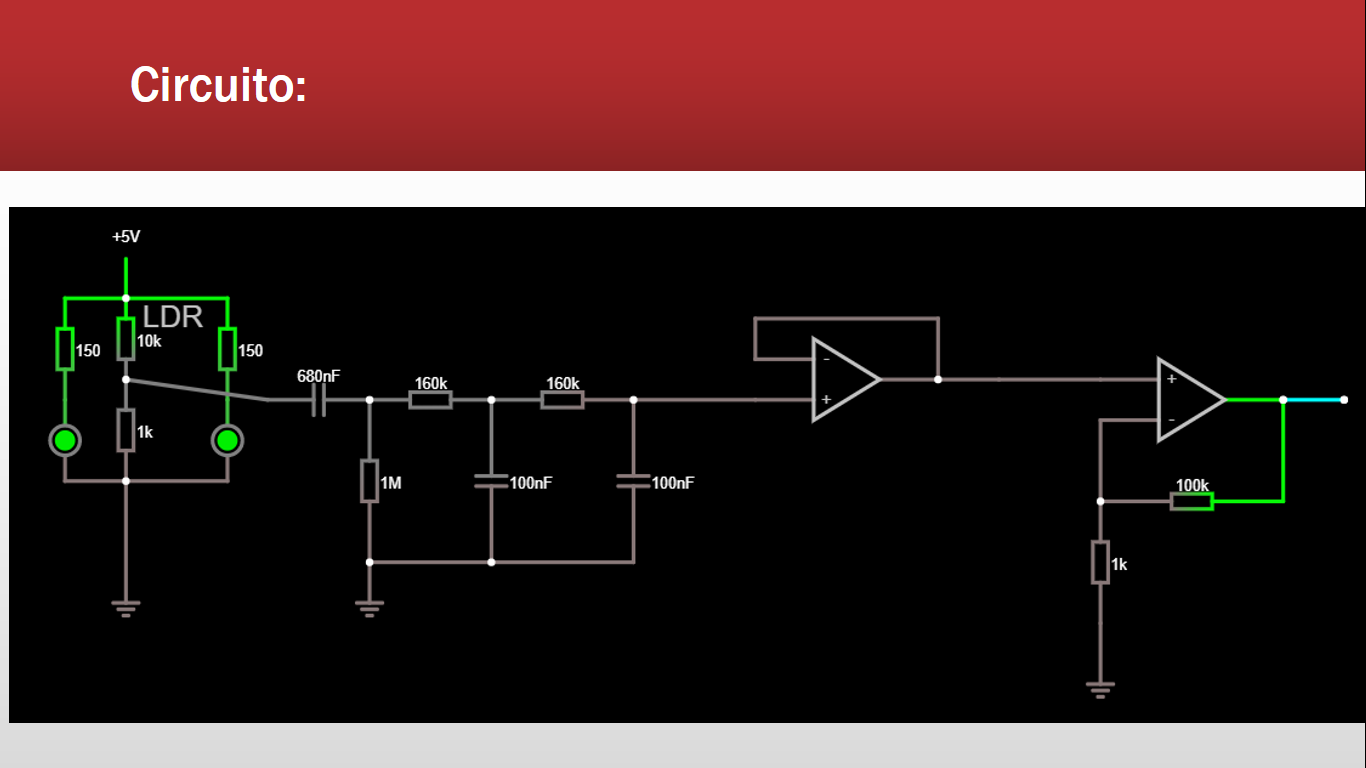
images/report_images/6.png
