Intuiti0n/Projeto1-Smartband/images/report_images/7.png

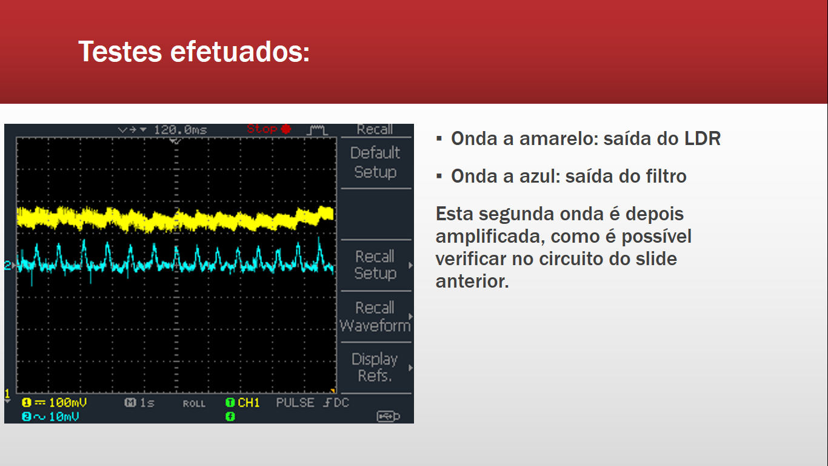
images/report_images/7.png
