Intuiti0n/Projeto1-Smartband/images/report_images/22243548_1664583973582988_1720340277_o.jpg

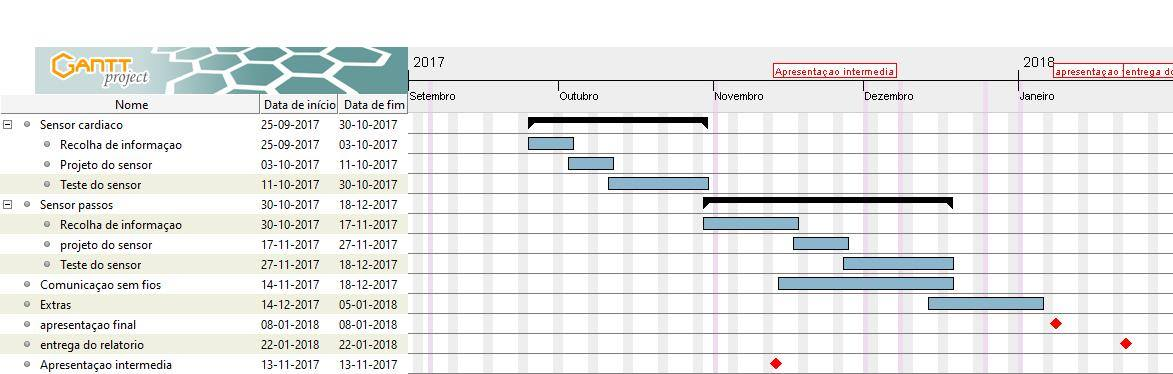
images/report_images/22243548_1664583973582988_1720340277_o.jpg
