Intuiti0n/Projeto1-Smartband/(list of files, cad)

Other CAD files:
pcb/SKETCH.skp
