Intuiti0n/Projeto1-Smartband/reports/steps.xlsx

Sheet: log10
-4280
-4372
-4296
-4176
-4152
-3984
-4188
-4200
-4188
-4064
-4156
-4200
-3984
-4008
-3992
-4056
-4276
-4160
-4060
-4172
-4116
-4120
-4120
-4032
-4140
-4056
-4272
-4288
-4064
-4128
-4224
-4024
-3900
-3968
-4040
-4132
-4188
-4100
-4076
-4148
-3940
-4192
-3972
-3828
-4080
-4272
-4168
-4092
-4012
-4012
-4072
-4028
-4136
-4128
-4100
-4016
-4020
-4012
-3996
-4256
-4196
-4068
-4152
-4192
-4188
-4212
-4156
-4172
-4056
-4132
-4080
-4116
-4096
-4168
-4248
-4132
-4072
-4216
-4040
-4272
-4120
-4252
-4116
-4192
-4128
-4172
-3928
-3944
-4200
-4116
-4140
-4116
-4156
-4048
-4116
-4148
-3792
-3944
-3788
-3804
-3920
-4052
-4232
-3832
-3924
-4132
-3896
-4192
-4252
-4172
-4172
-4264
-4288
-4356
-3688
-3864
-3400
-2344
-1572
-600
-2008
-2044
-3744
-2948
-6260
-6396
-8968
-9480
-8420
-8216
-5060
-5800
-4372
-2580
-3096
-1828
-1300
-2500
-3680
-4020
-7544
-7792
-3800
-3128
-7392
-9536
-7528
-8624
-9424
-10160
-7848
-8304
-8712
-3552
-3036
-3508
-3740
-4612
-4068
-3624
-3260
-2168
-1196
-1832
-2772
-3112
-6340
-9224
-8872
-3092
-2612
-5628
-6620
-4540
-5508
-6200
-2248
-5344
-14848
-1160
3268
-220
-3748
-2296
-408
84
-572
-616
-2880
-7192
-9360
-14192
-12136
-11120
-9736
-7508
-6556
-5900
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
