Intuiti0n/Projeto1-Smartband/code/steps/steps.xlsx

Sheet: Folha1
9.00 | Grafico
-1.00 | -14.36
-22.00 | 3.56
461.00
-57.00
-42.00 | 72.19
3.00 | 60.46
3.00 | 47.69
7.00 | 3.02
0.00 | 34.15
-5.00 | 16.75
-9.00 | -6.56
-15.00 | -30.52
-7.00 | -39.58
13.00 | -29.63
26.00 | 9.44
22.00 | 45.00
16.00 | 30.89
8.00 | 20.32
-6.00 | 16.38
-14.00 | 30.23
-10.00 | 53.96
-3.00 | 69.62
1.00 | 72.19
12.00 | 60.46
20.00 | 47.69
10.00 | 43.02
-6.00 | 34.15
-8.00 | 16.75
5.00 | -6.56
21.00 | -30.52
21.00 | -39.58
0.00 | -29.63
-28.00
-51.00 | -10.2
-61.00 | -18.44
-57.00 | -29.13
-42.00 | -35.23
-25.00 | -39.94
-15.00 | -52.50
 | -68.08
8.00 | -74.53
-8.00 | -68.95
-14.00 | -51.11
7.00 | -21.86
43.00 | 6.98
67.00 | 17.51
71.00 | 9.04
60.00 | -4.94
37.00 | -15.99
17.00 | -19.60
16.00 | -13.76
32.00 | -13.82
42.00 | -31.87
28.00 | -47.91
1.00 | -41.57
-12.00 | -20.71
-9.00 | -1.93
-12.00 | 9.98
-23.00 | 17.95
-29.00 | 18.13
-32.00 | 6.43
-39.00 | -5.01
-44.00 | -7.14
-40.00 | 2.00
-37.00 | 12.56
-37.00 | 1.64
-31.00 | -29.21
-18.00 | -59.74
0.00 | -77.93
17.00 | -77.40
31.00 | -55.11
36.00 | -25.65
30.00 | -4.62
15.00 | 20.17
-9.00 | 51.92
-42.00 | 70.36
-61.00 | 63.56
-53.00 | 36.71
-32.00 | 17.14
-23.00 | 17.93
-35.00 | 20.07
-49.00 | 20.52
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
