Intuiti0n/Projeto1-Smartband/images/steps/25829576_1763922016982516_1978748101_o.jpg

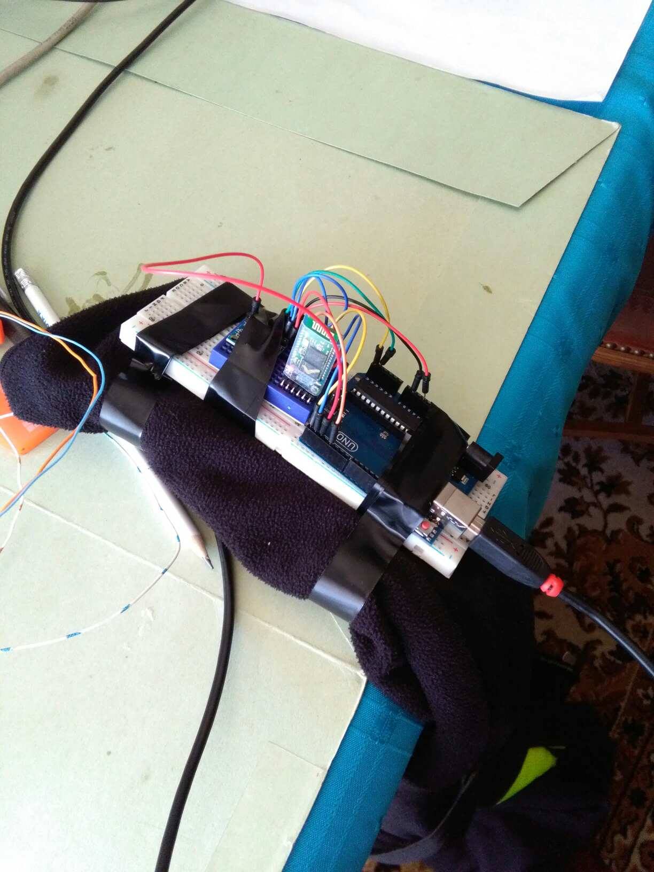
images/steps/25829576_1763922016982516_1978748101_o.jpg
