Intuiti0n/Projeto1-Smartband/images/steps/25829627_1763921963649188_1542034592_o.jpg

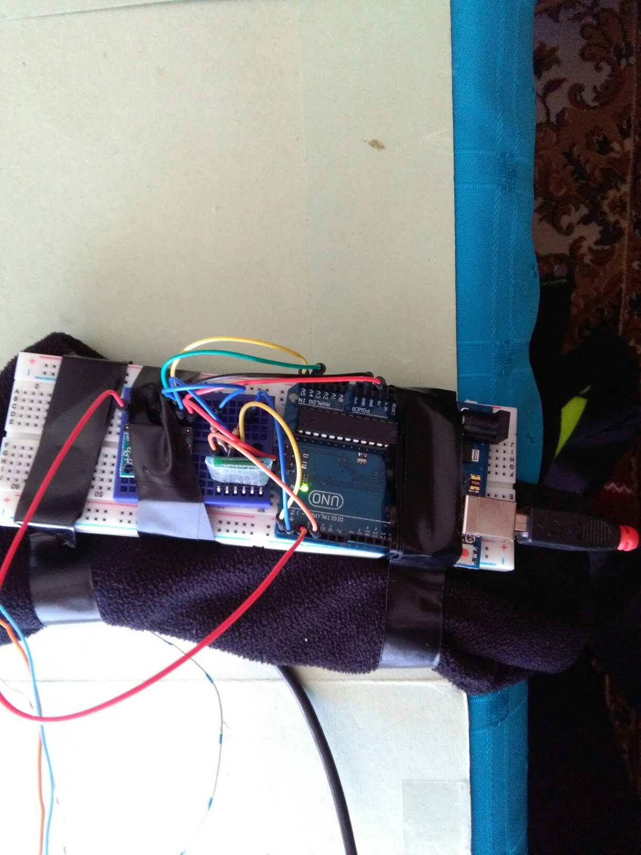
images/steps/25829627_1763921963649188_1542034592_o.jpg
