Intuiti0n/Projeto1-Smartband/images/steps/mpu 6050.jpg

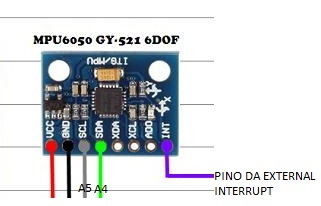
images/steps/mpu 6050.jpg
