Intuiti0n/Projeto1-Smartband/pcb/print_pcb_side_to_side_paint_skills.png

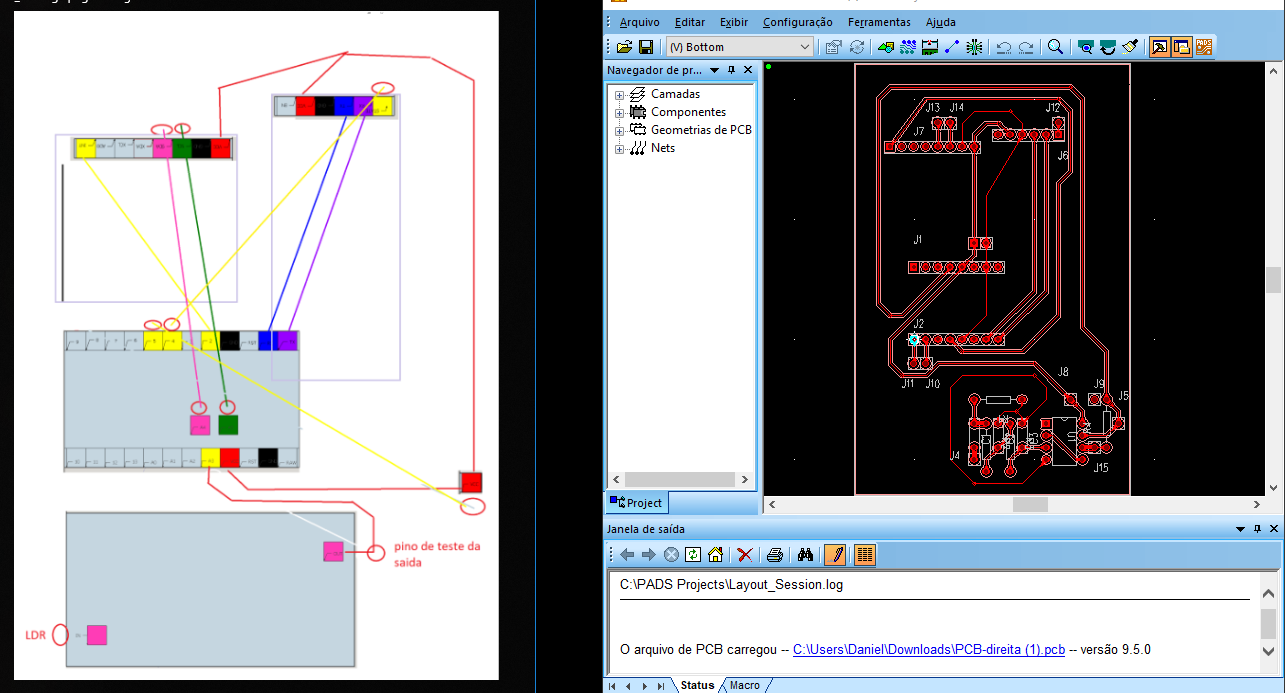
pcb/print_pcb_side_to_side_paint_skills.png
