Intuiti0n/Projeto1-Smartband/images/PCB/teste_routing2.png

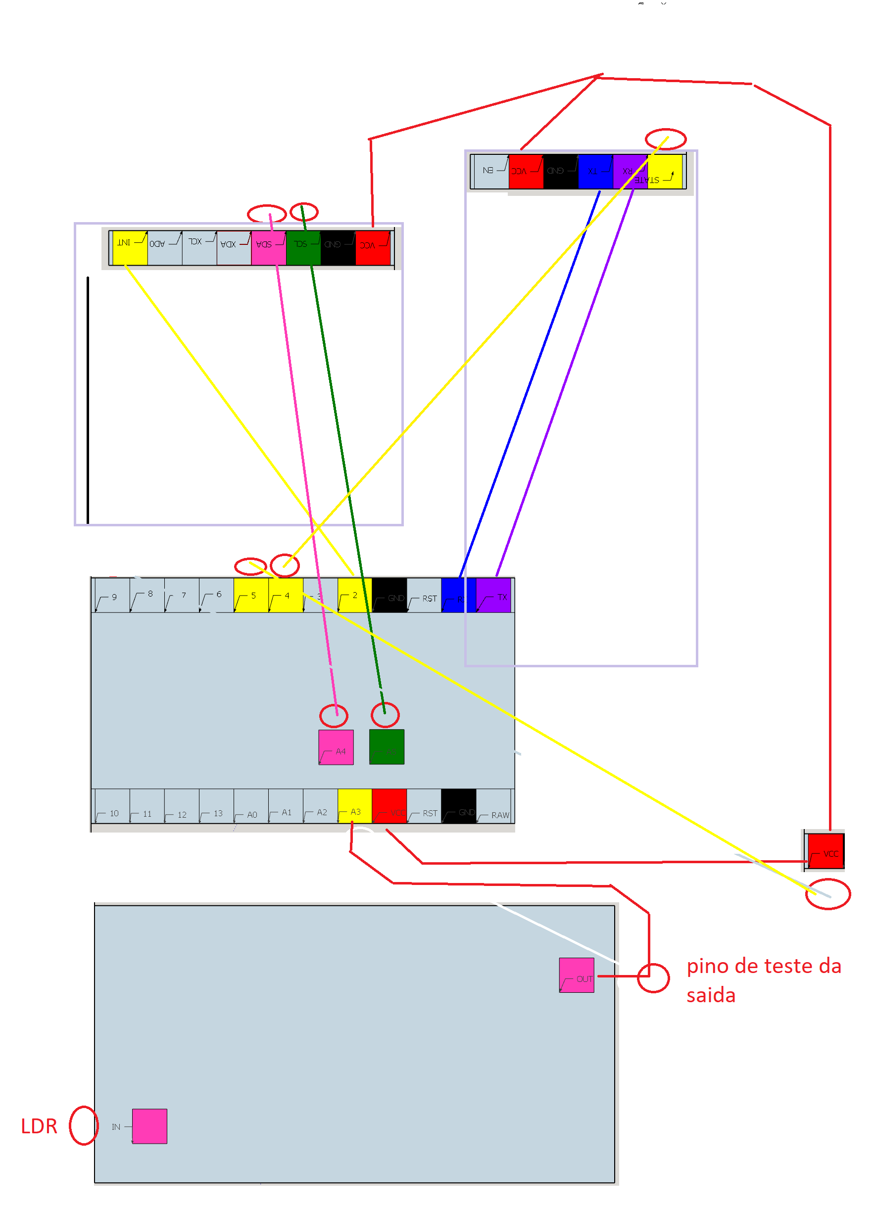
images/PCB/teste_routing2.png
