Intuiti0n/Projeto1-Smartband/images/PCB/teste_routing.png

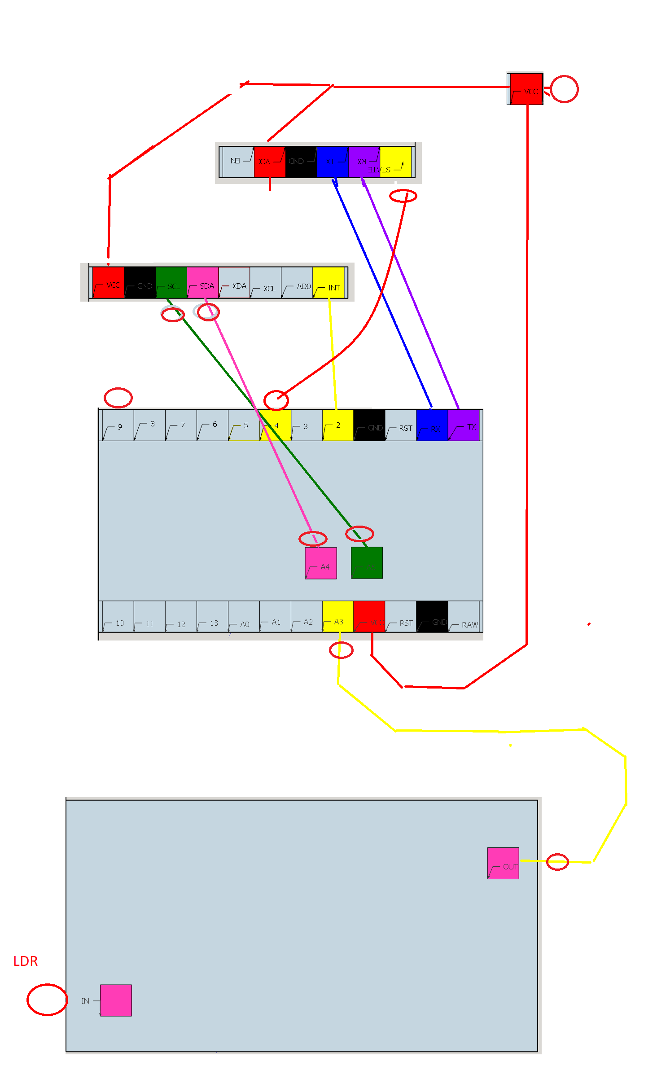
images/PCB/teste_routing.png
