Intuiti0n/Projeto1-Smartband/multisim/heartbeat_sensor.pdf

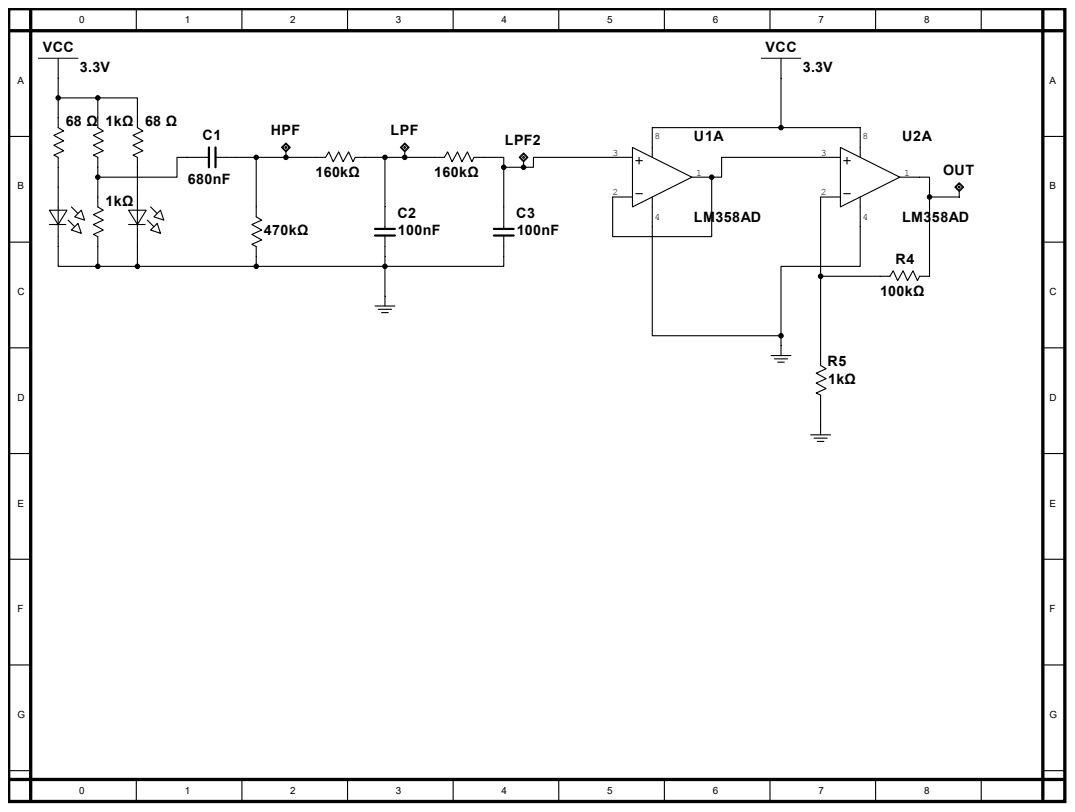
[picture p92: page 1]
VCC; HPF; LPF; LPF2; OUT
