Intuiti0n/Projeto1-Smartband/(list of files, drawings)

Other design files:
multisim/heartbeat_sensor.ms12
pcb/ENVIAR/PCB-direita.pcb
