Intuiti0n/Projeto1-Smartband/(commit log)

2017-12-20 added images, changed code for heart sensor, works better now, changed supply voltage to 3.3V
2017-12-20 added branch for digital filter test and analysis
2017-12-20 updated heartbeat sensor code to adjust for the filter changes and for sampling changes, works well on the finger, needs to improve on the arm
2017-12-22 changed alot of things, commented the code for bluetooth, heartbeat sensor and pedometer sensor
2017-12-22 added circuit file for multisim 12, with pdf print
    [heartbeat_sensor.ms12]
2017-12-29 added images for the circuit, updated the final report, added more text
2018-01-03 update final report
    [compras.xlsx]
2018-01-04 added code tests for the steps, now testing the steps data
    [PCB-Projeto-1.sch, PCB-direita.pcb, steps.xlsx]
2018-01-04 fixed code variables for steps and i2c aquiring from the MPU-6050
    [main_project.ino, steps.ino]
2018-01-04 added PCB sketch to help understand how to put each pin
    [SKETCH.skp]
2018-01-05 added images for the pcb design, changed the sketchup sketch for the pcb
    [SKETCH.skp]
2018-01-08 added new code for steps, testing the 3 axis step calculator
    [PCB-direita.pcb, SKETCH.skp, steps.xlsx]
2018-01-08 steps are now working, needs more tests to only detect steps
    [PCB-Projeto-1.sch, PCB-direita.pcb, steps.xlsx, steps_telemovel.xlsx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]
2018-01-08 mais compras na folha
    [compras.xlsx]
2018-01-08 changed main project code to the current version of working steps
2018-01-09 update readme with more images
    added description for the heart sensor images, filter design and principle
2018-01-09 update compras
    [compras.xlsx]
2018-01-17 added more stuff on the reports, final design for presentation on the heart module
    [compras.xlsx]
2018-01-17 more stuff for the report, steps sensor added
2018-01-22 added shopping list
    [compras.xlsx]
